IWong29/batterycharacterization/BatteryTesterV2.1.pdf

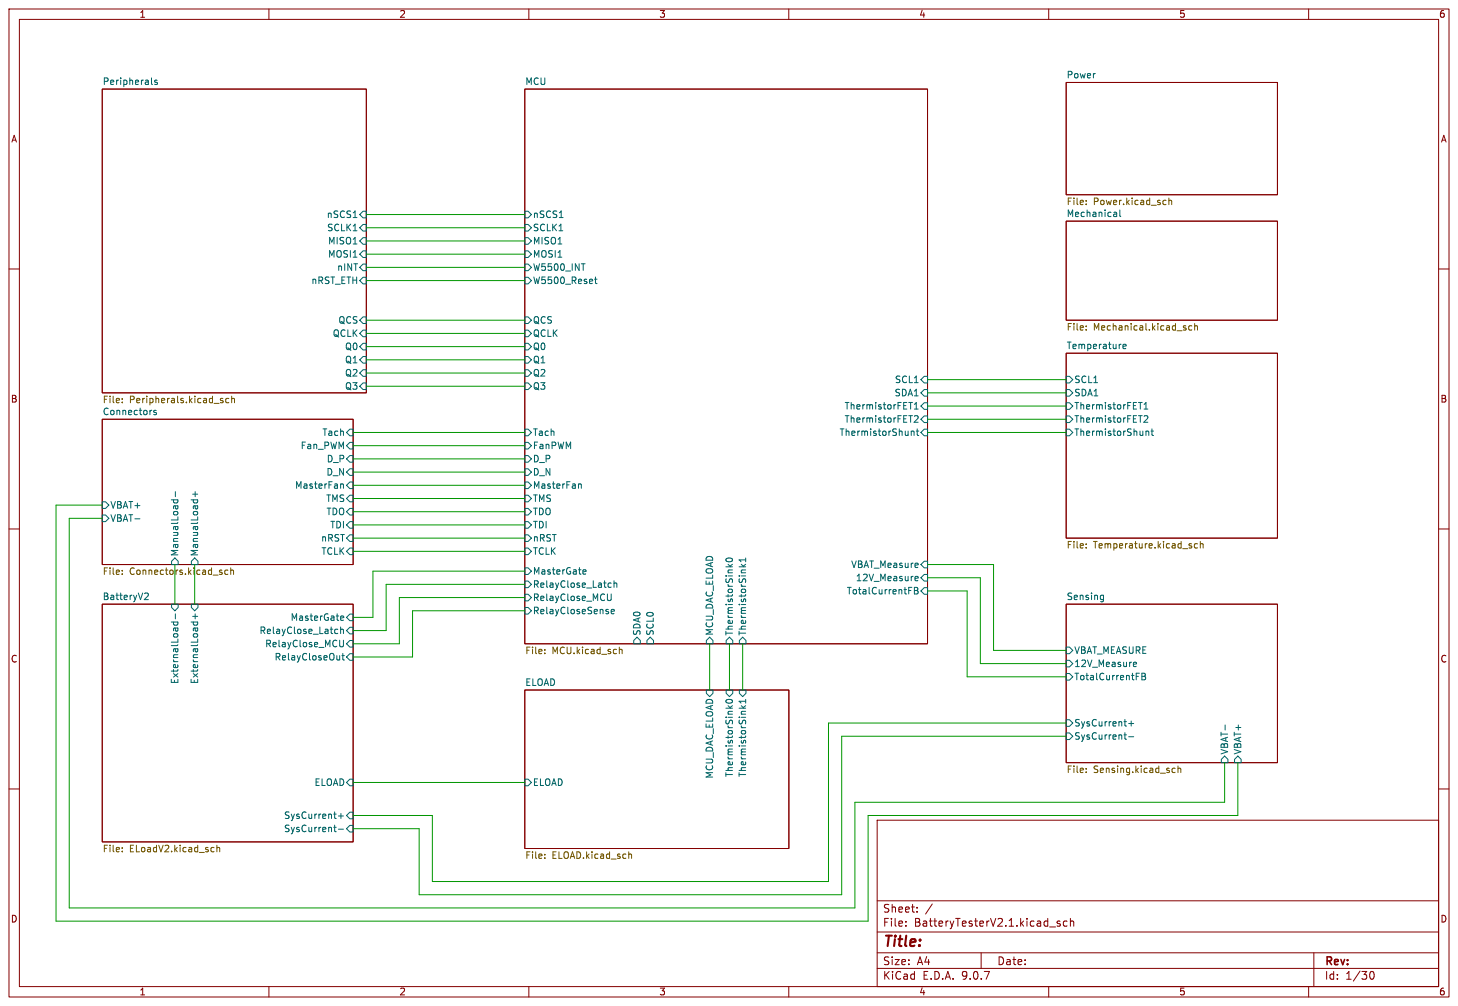
[picture p1: page 1]

Tach MasterFan VBAT+ VBAT- Connectors File: Connectors.kicad_sch

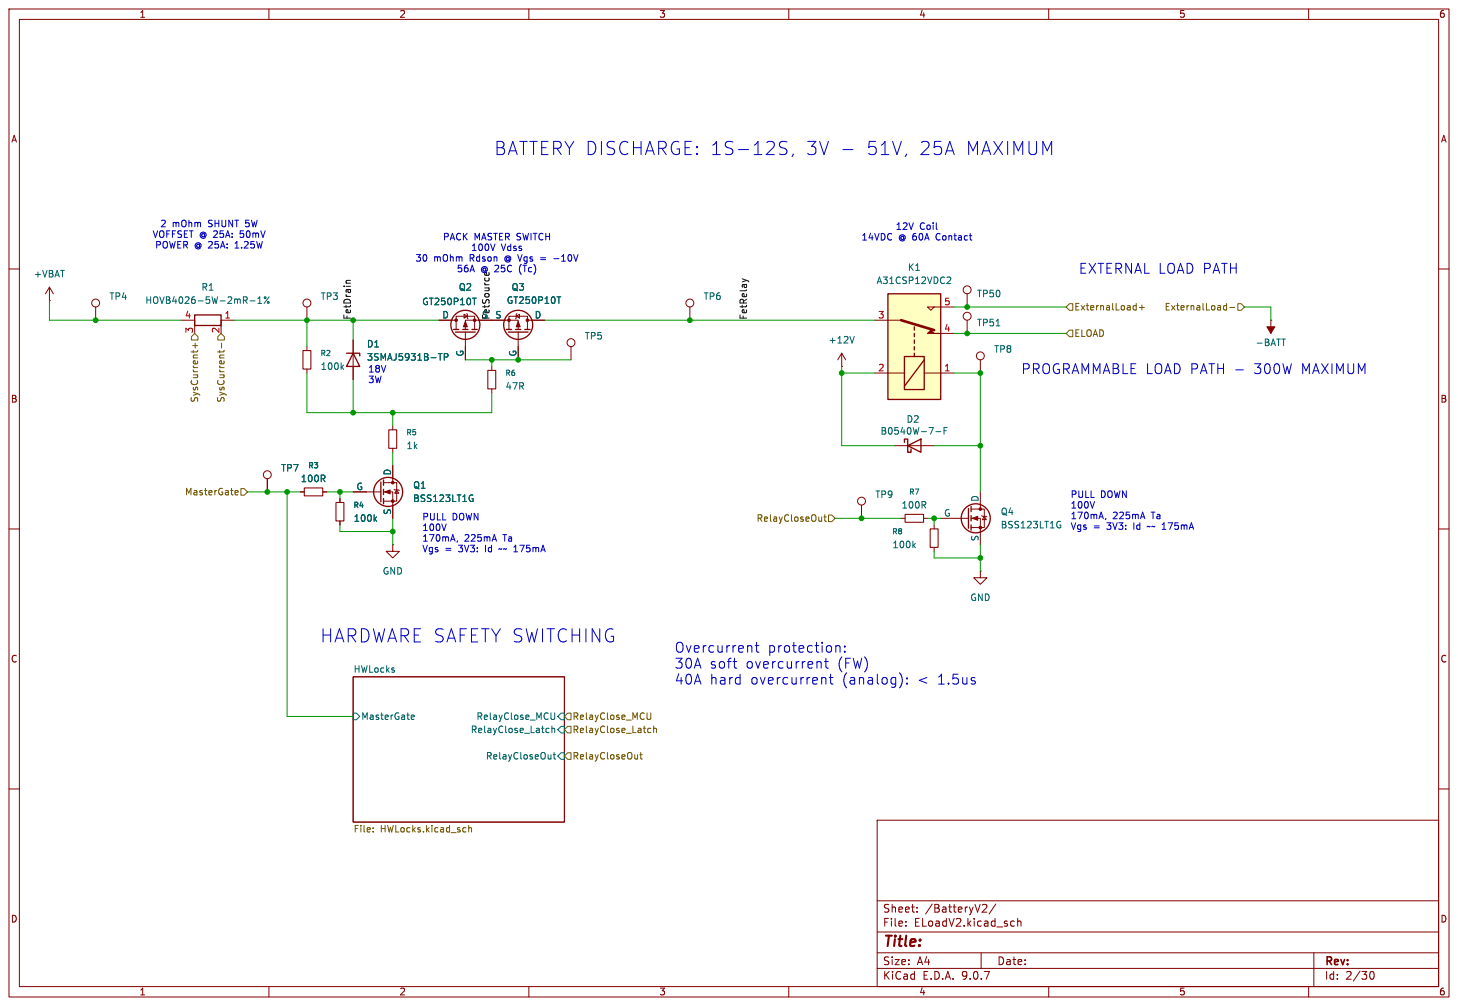
[picture p2: page 2]

100V Vdss 30 mOhm Rdson @ Vgs = -10V

170mA, 225mA Ta Vgs = 3V3: Id ~~ 175mA EXTERNAL LOAD PATH

ExternalLoad+ ELOAD MasterGate SysCurrent+

Id: 2/30 Title: File: ELoadV2.kicad_sch Sheet: /BatteryV2/

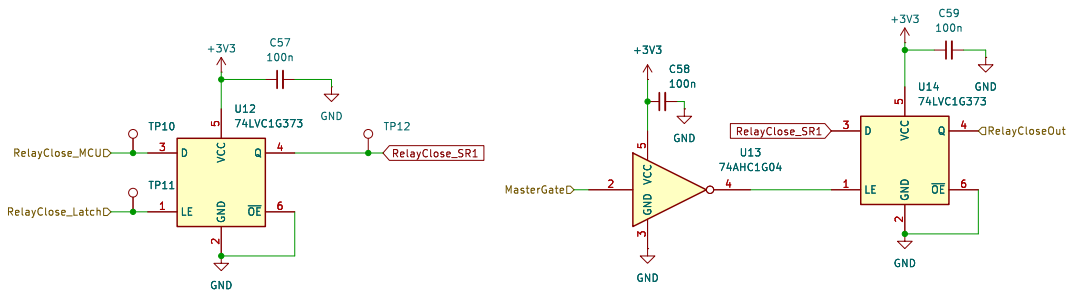
[picture p3: page 3]

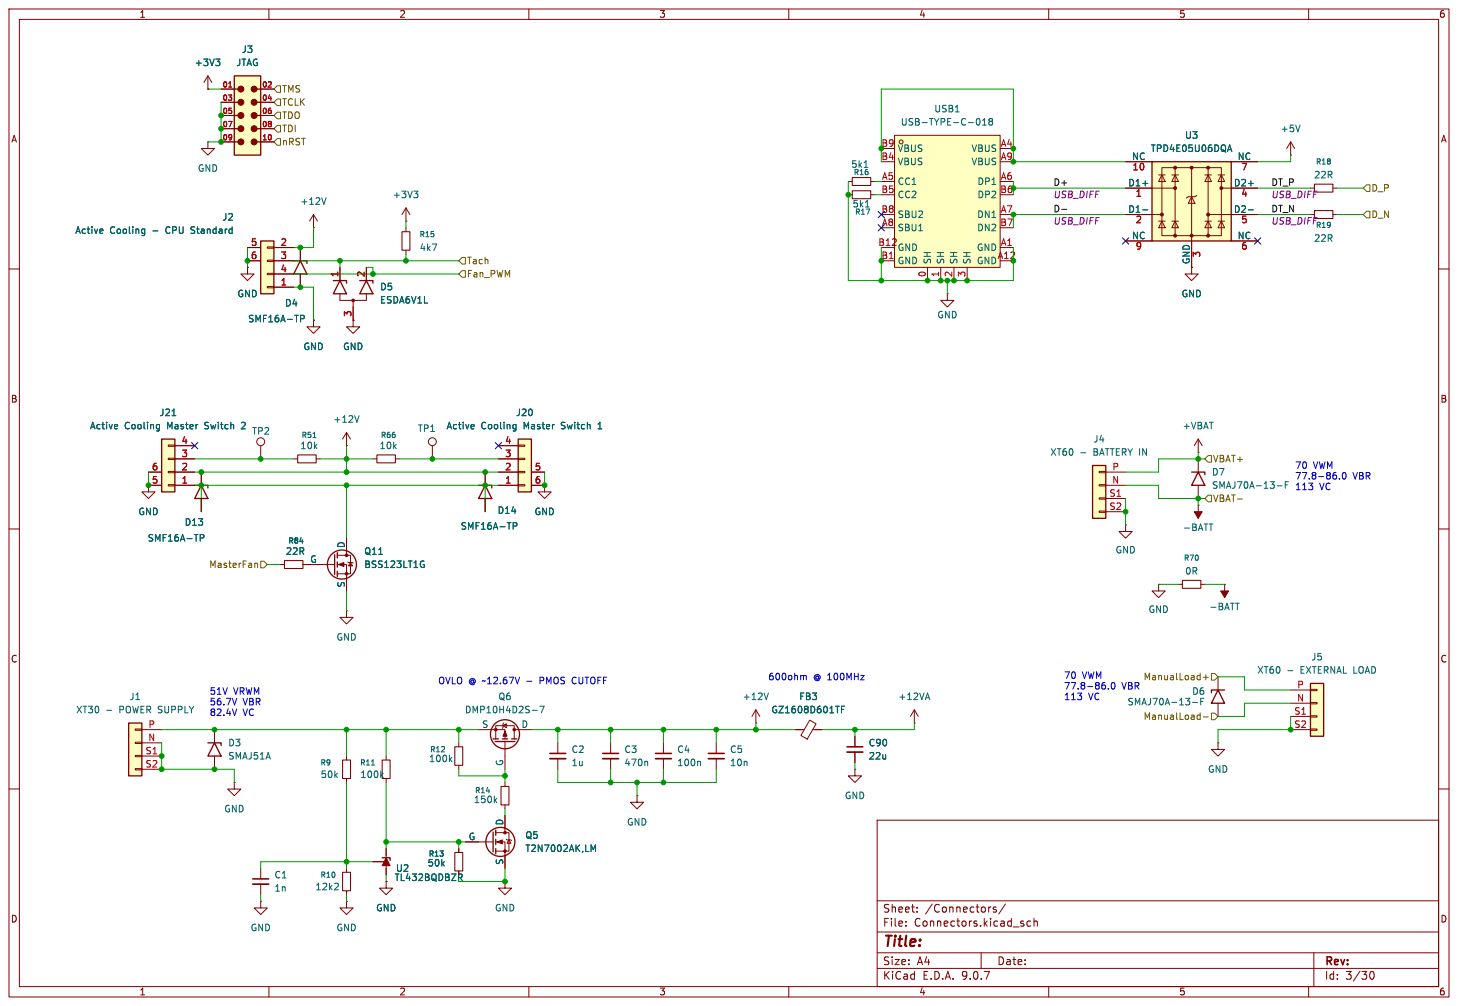
[picture p4: page 4]

3 VBUS A4 VBUS A9 DP1 A6 DP2 B6 DN1 A7 DN2 B7 GND A1 GNDA12 USB1 USB-TYPE-C-018 GND

J21 Active Cooling Master Switch 2

J20 Active Cooling Master Switch 1

Id: 3/30 Title: File: Connectors.kicad_sch Sheet: /Connectors/ FB3 GZ1608D601TF GND

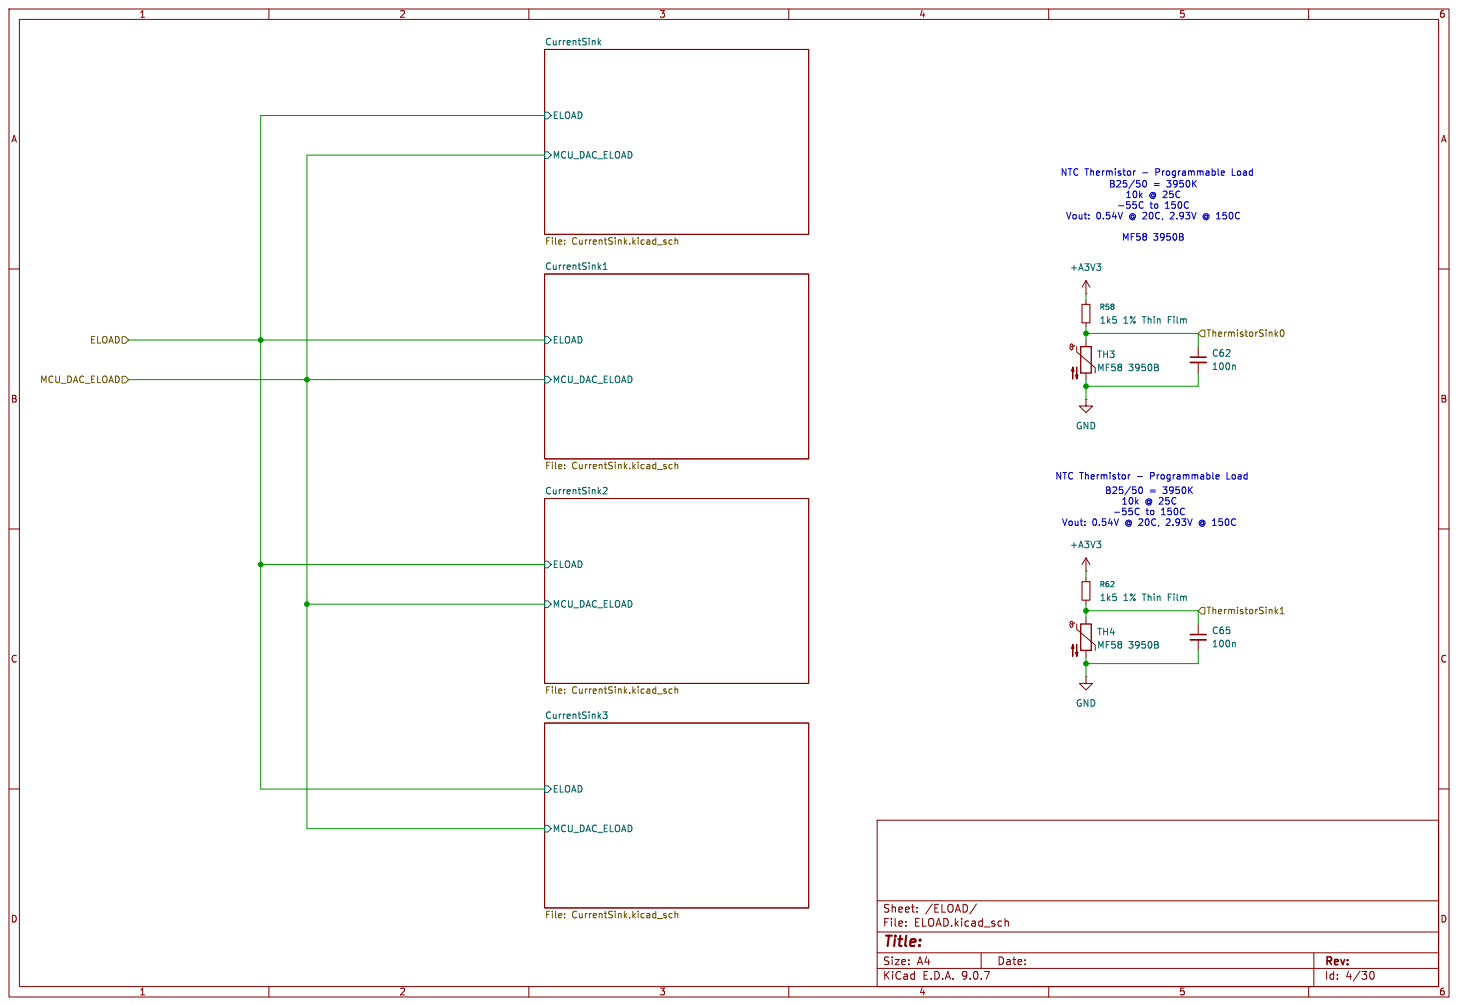
[picture p5: page 5]

Id: 4/30 Title: File: ELOAD.kicad_sch Sheet: /ELOAD/

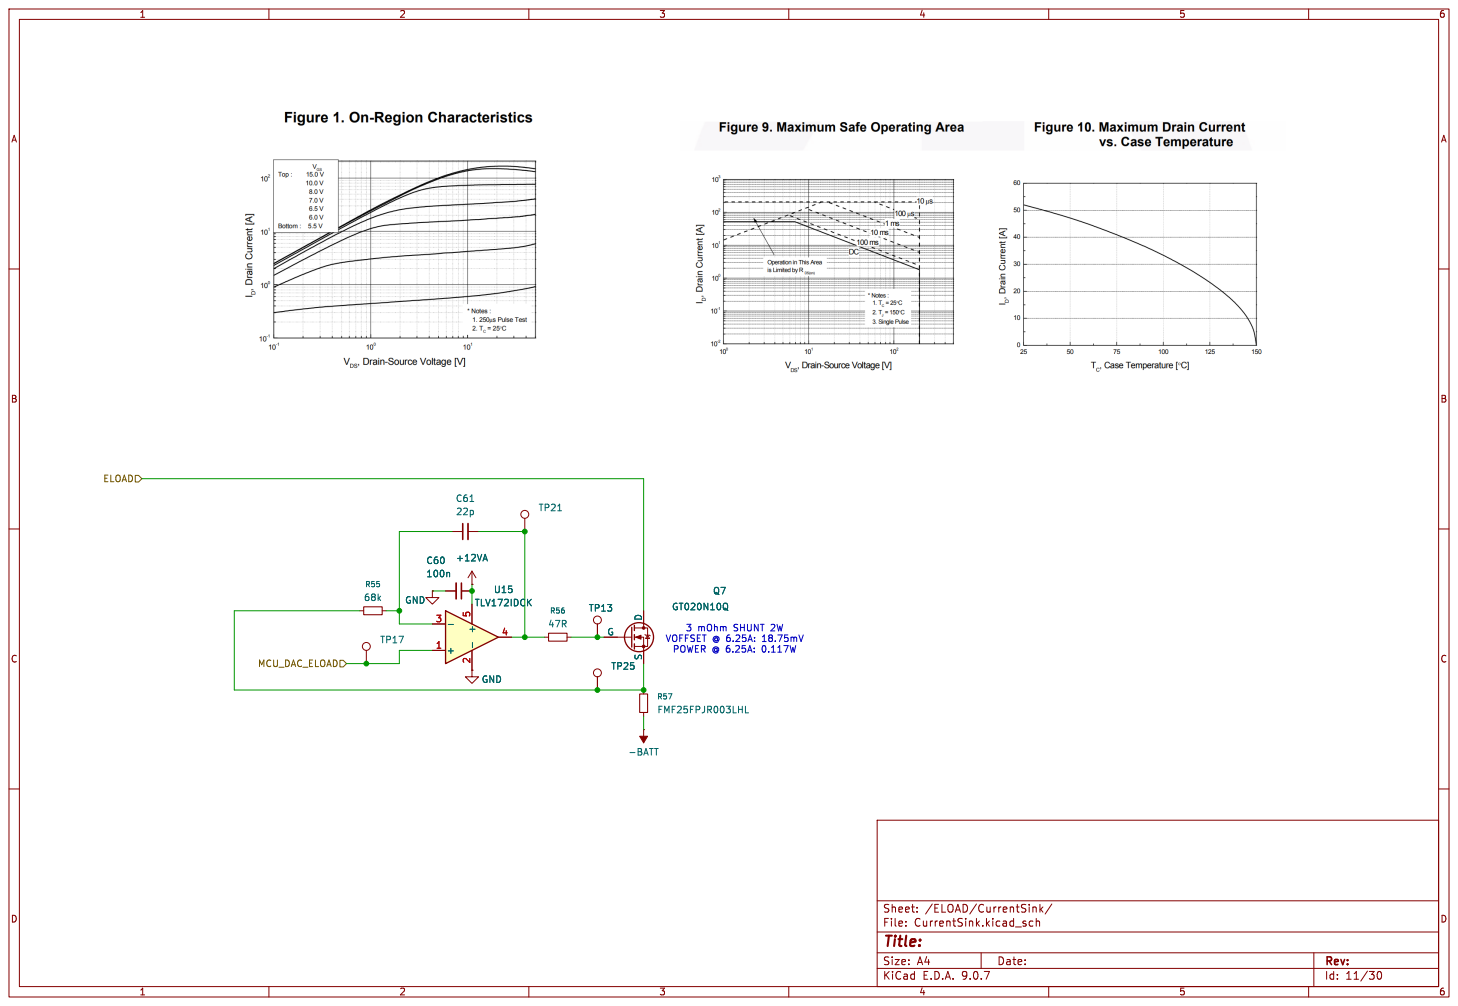
[picture p6: page 6]

Id: 11/30 Title: File: CurrentSink.kicad_sch Sheet: /ELOAD/CurrentSink/ TP13 GND

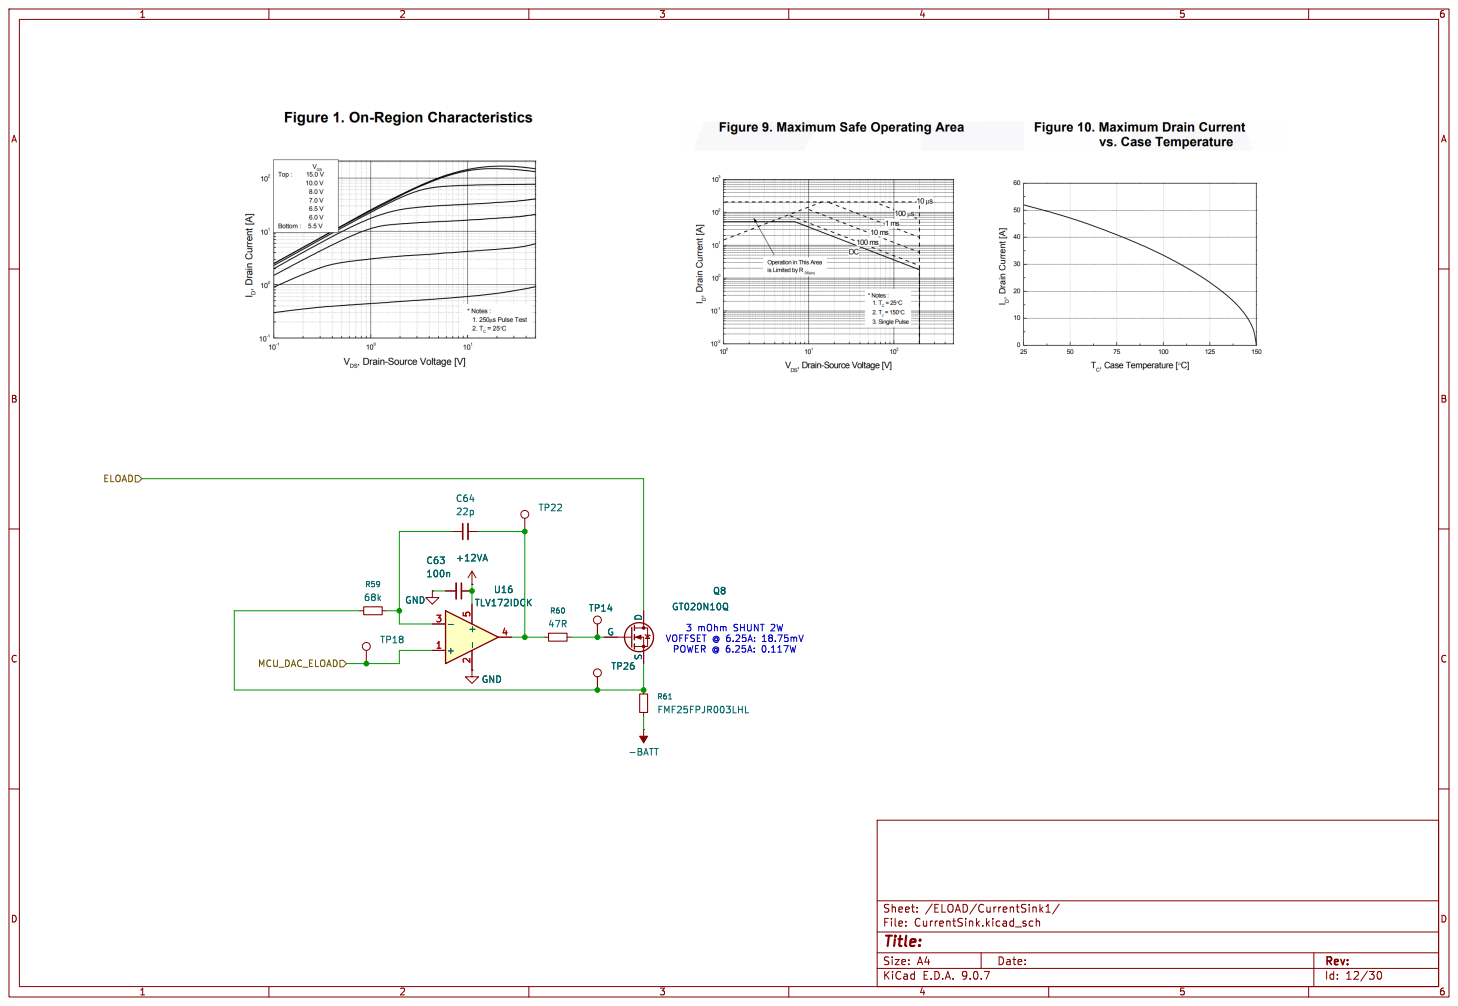
[picture p7: page 7]

Id: 12/30 Title: File: CurrentSink.kicad_sch Sheet: /ELOAD/CurrentSink1/ GND

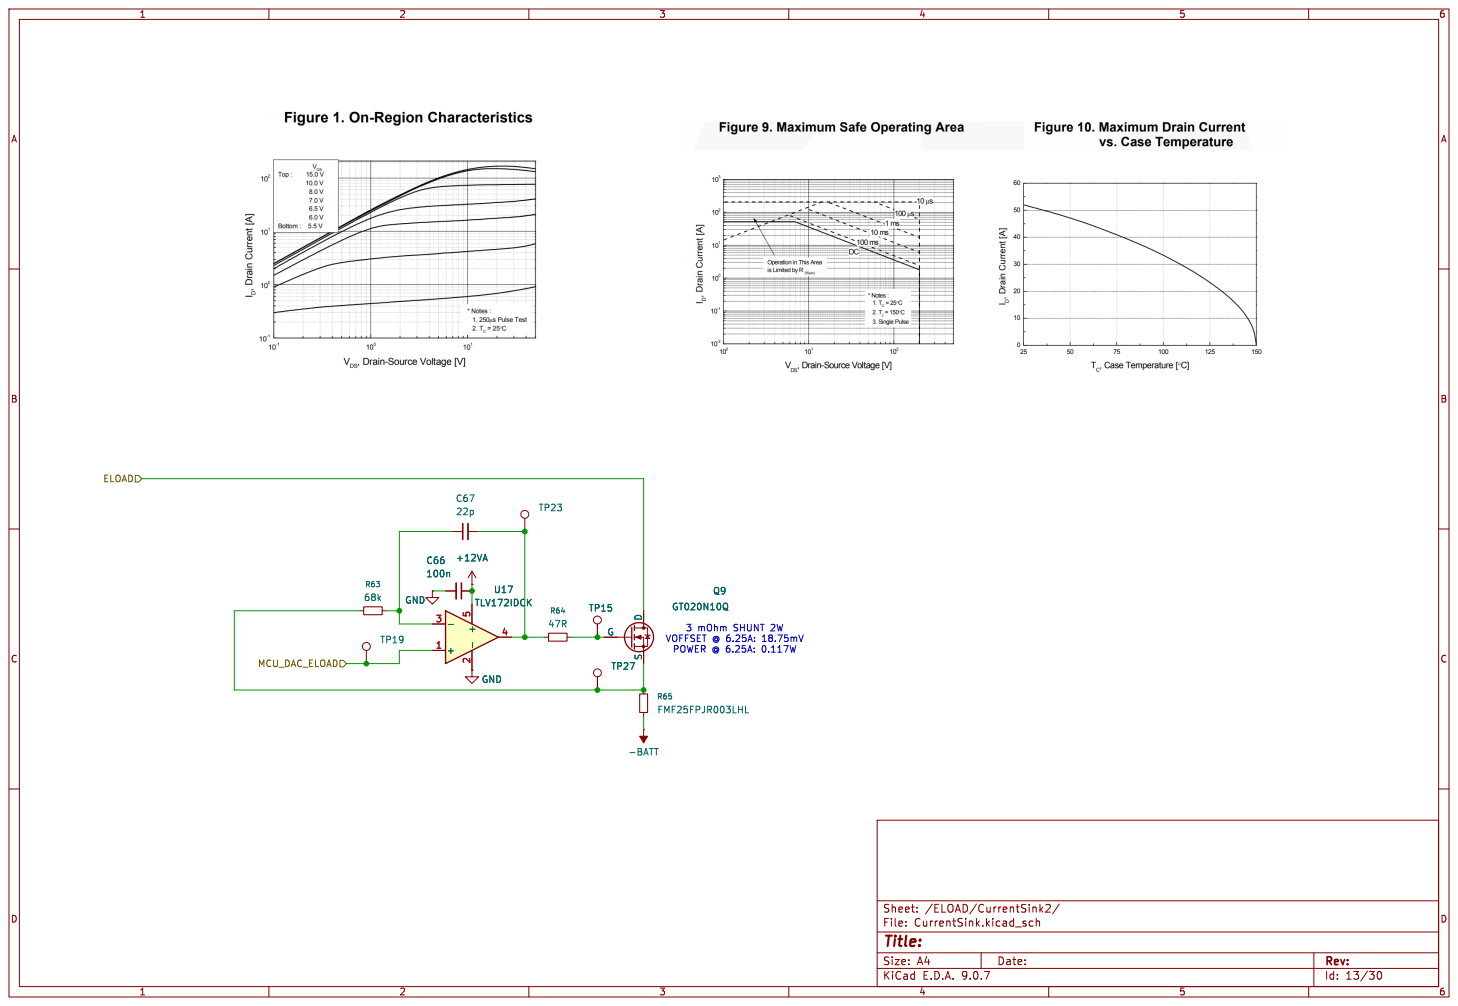
[picture p8: page 8]

Id: 13/30 Title: File: CurrentSink.kicad_sch Sheet: /ELOAD/CurrentSink2/

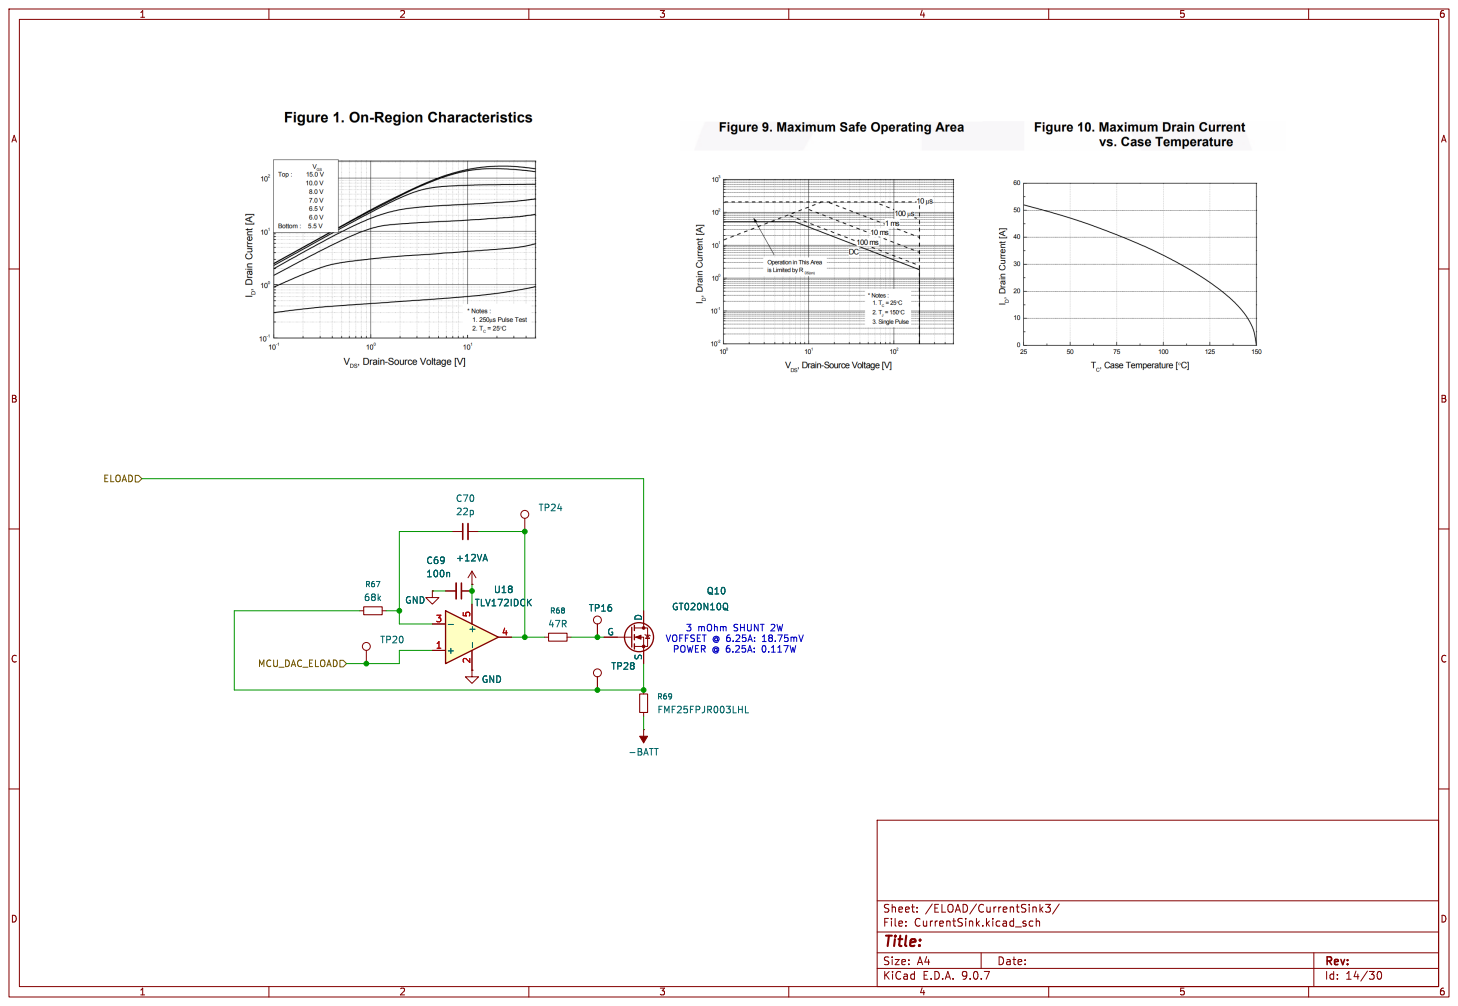
[picture p9: page 9]

Id: 14/30 Title: File: CurrentSink.kicad_sch Sheet: /ELOAD/CurrentSink3/ TP16 GND

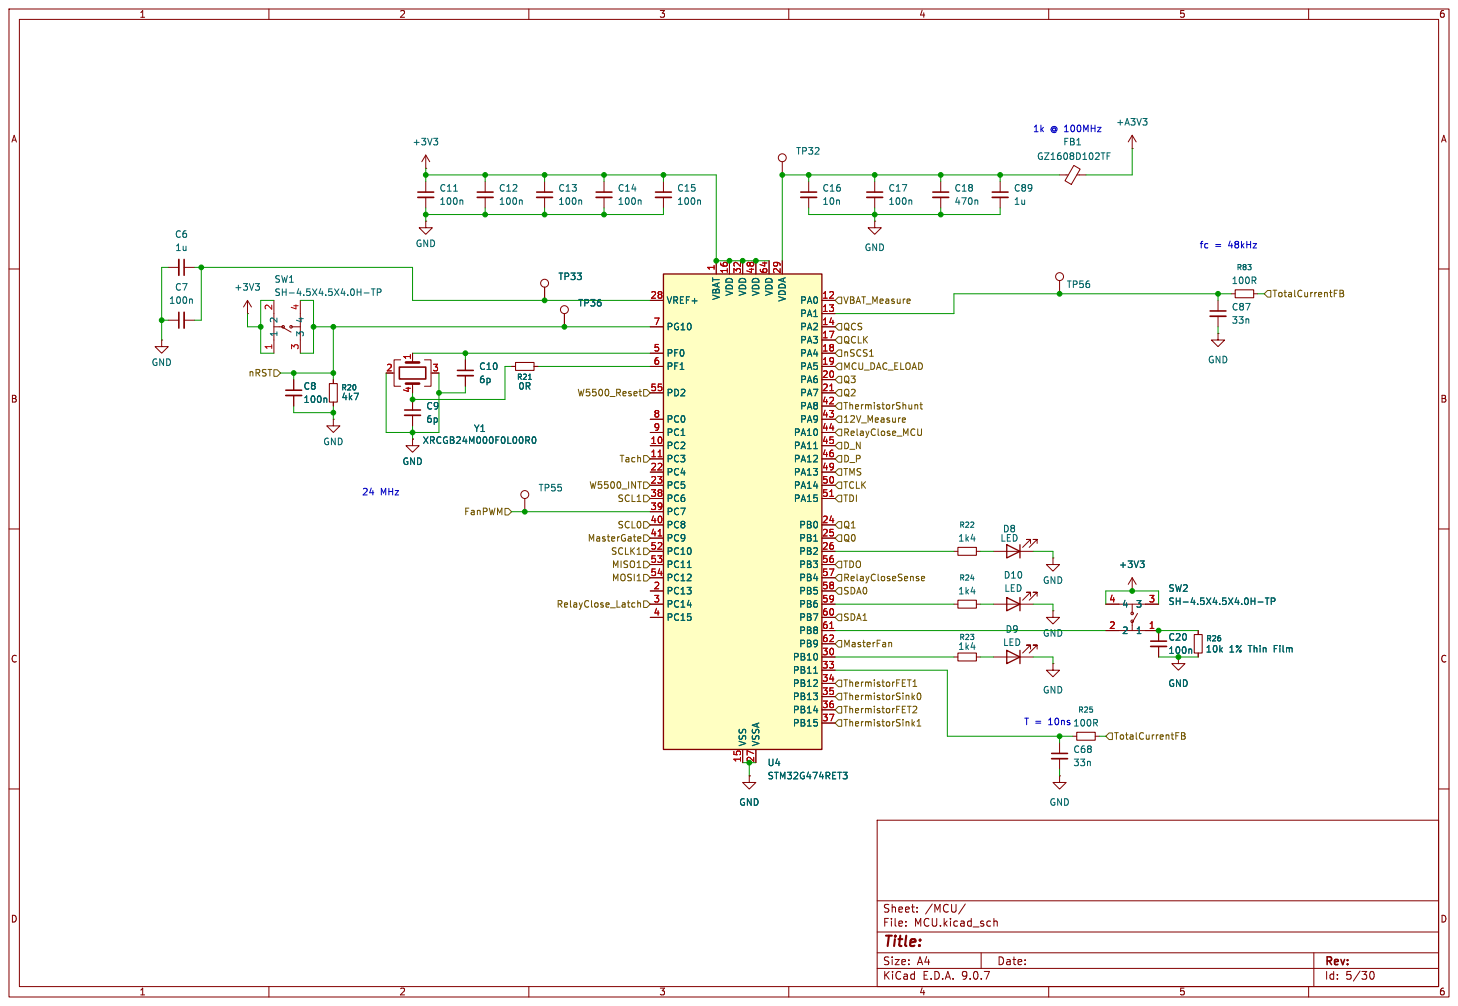
[picture p10: page 10]

1 VDD 16 VDD 32 VSS 15 VDD 48 VSSA 27 VDD 64 VDDA 29 PA0 12 PA1 13 PA2 14 PA3 17 PA4 18 PA5 19 PA6 20 PA7 21 PA8 42 PA9 43 PA10 44 PA11 45 PA12 46 PA13 49 PA14 50 PA15 51 PB0 24 PB1 25 PB2 26 PB3 56 PB4 57 PB5 58 PB6 59 PB7 60 PB8 61 PB9 62 PB10 30 PB11 33 PB12 34 PB13 35 PB14 36 PB15 37 U4STM32G474RET3 GND

1 VDD 16 VDD 32 VSS 15 VDD 48 VSSA 27 VDD 64 VDDA 29 PA0 12 PA1 13 PA2 14 PA3 17 PA4 18 PA5 19 PA6 20 PA7 21 PA8 42 PA9 43 PA10 44 PA11 45 PA12 46 PA13 49 PA14 50 PA15 51 PB0 24 PB1 25 PB2 26 PB3 56 PB4 57 PB5 58 PB6 59 PB7 60 PB8 61 PB9 62 PB10 30 PB11 33 PB12 34 PB13 35 PB14 36 PB15 37 GND

Id: 5/30 Title: File: MCU.kicad_sch Sheet: /MCU/ GND

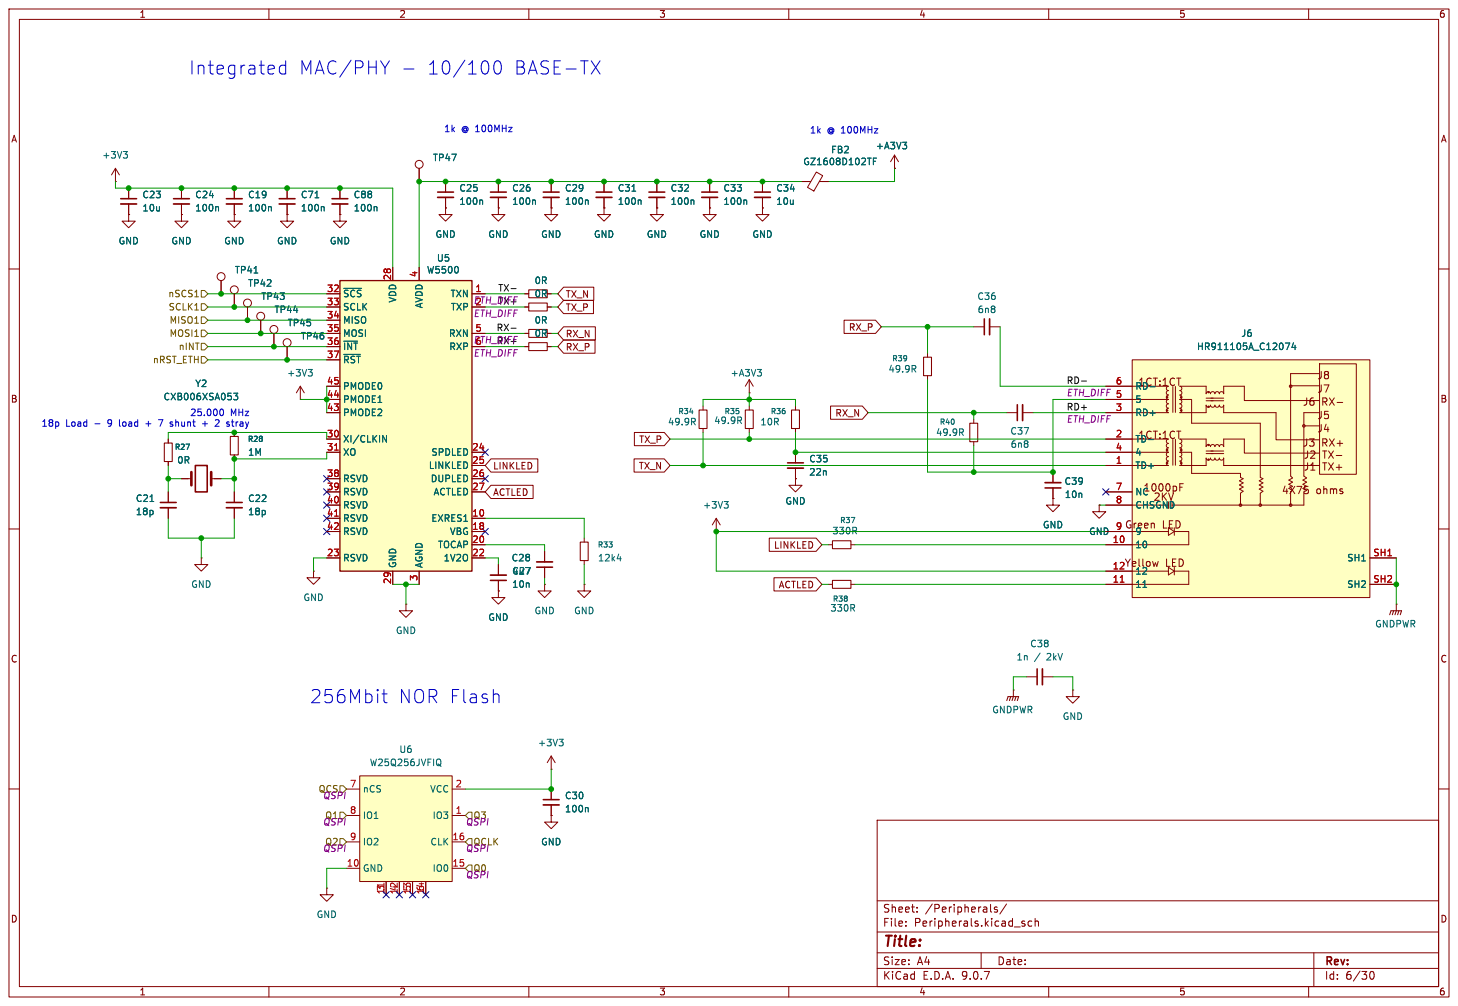
[picture p11: page 11]

3 TXN 1 TXP 2 RXN 5 RXP 6 SPDLED 24

LINKLED 25 DUPLED 26 ACTLED 27 EXRES1 10 VBG 18 TOCAP 20

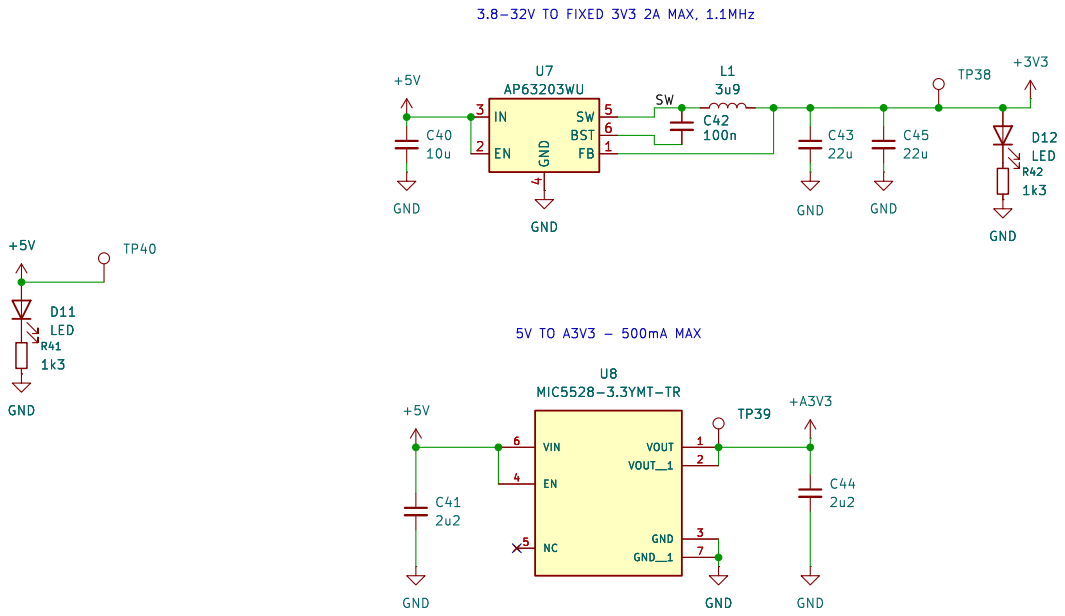
[picture p12: page 12]

4 SW 5 BST 6 FB 1 U7 AP63203WU GND GND GND

4 SW 5 BST 6 FB 1 GND

Id: 7/30 Title: File: Power.kicad_sch Sheet: /Power/

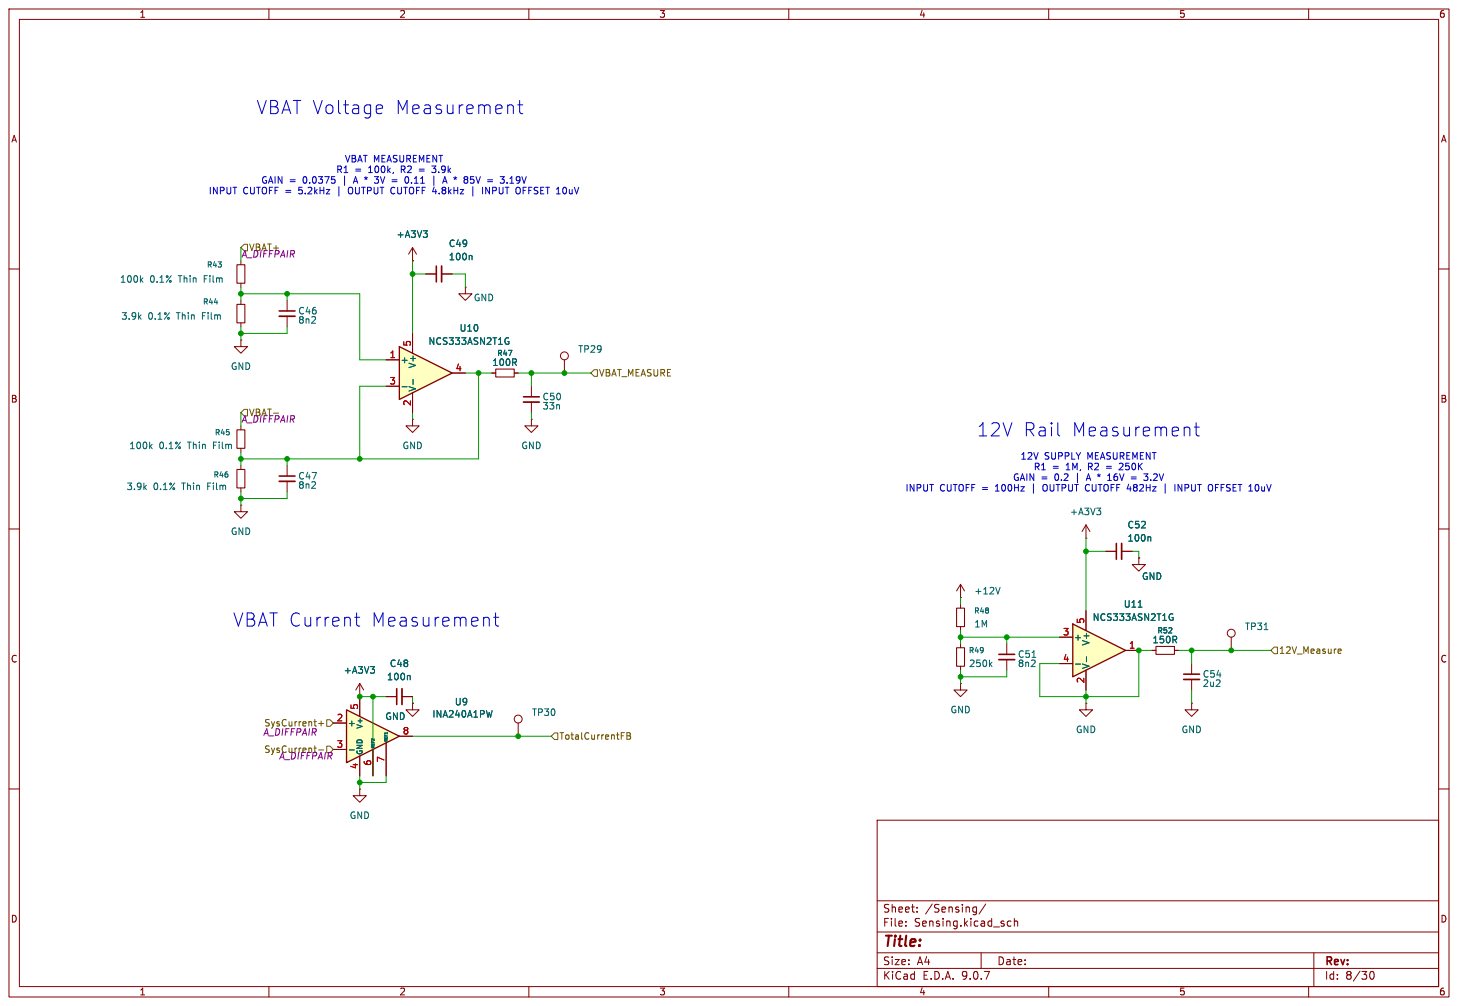
[picture p13: page 13]

INPUT CUTOFF = 100Hz | OUTPUT CUTOFF 482Hz | INPUT OFFSET 10uV

Id: 8/30 Title: File: Sensing.kicad_sch Sheet: /Sensing/ GND

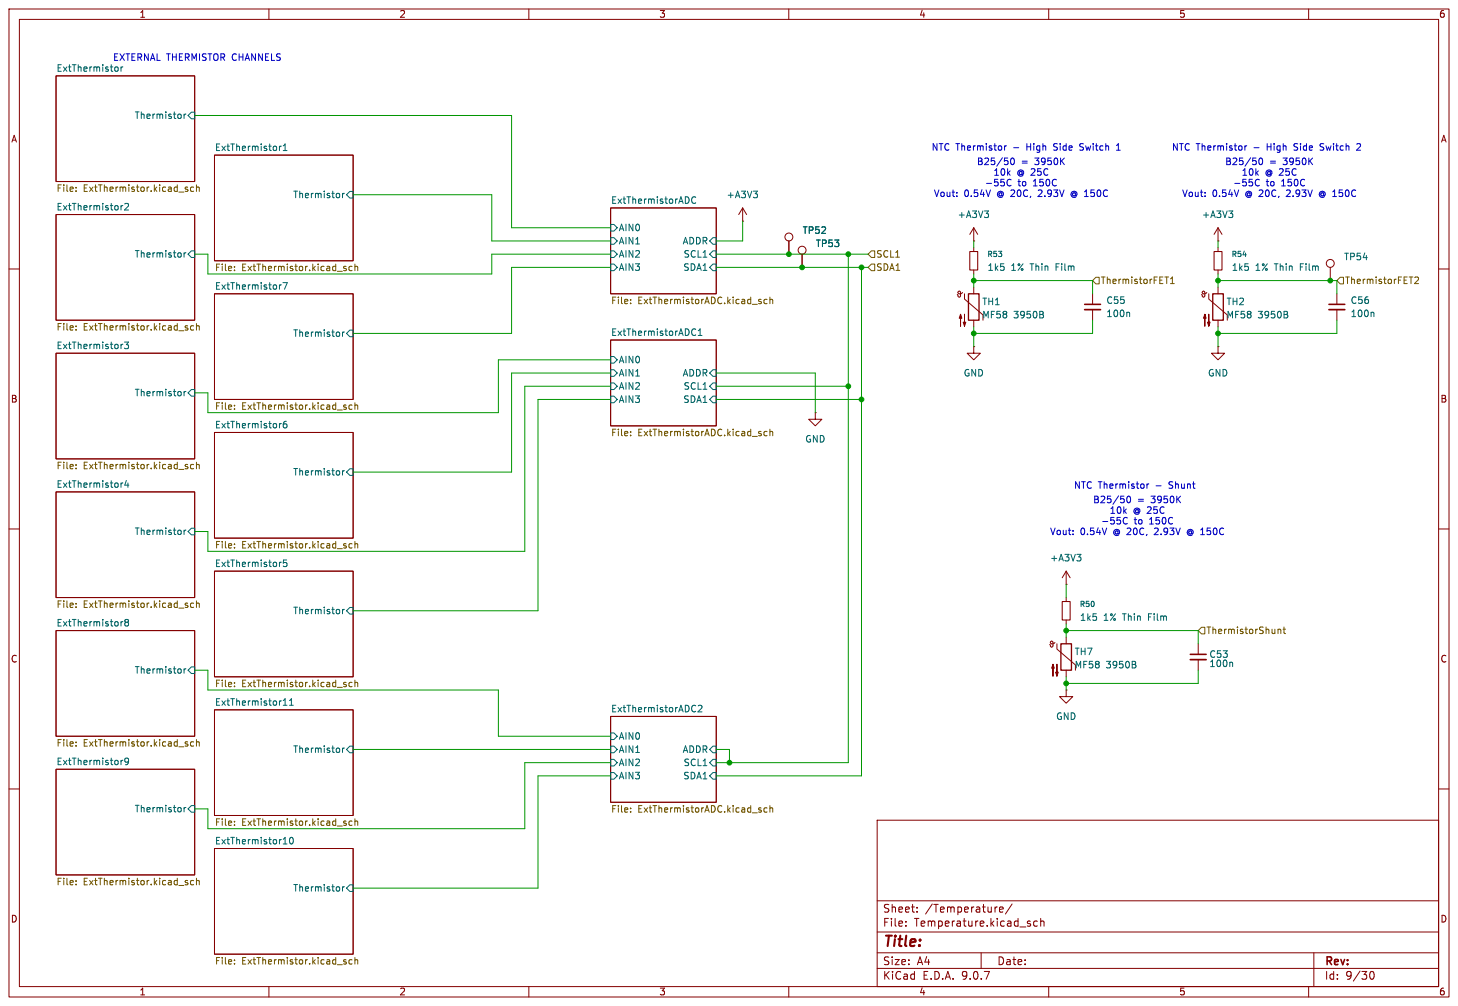
[picture p14: page 14]

Thermistor ExtThermistor7 File: ExtThermistor.kicad_sch Thermistor ExtThermistor File: ExtThermistor.kicad_sch Thermistor ExtThermistor4 File: ExtThermistor.kicad_sch Thermistor ExtThermistor9 File: ExtThermistor.kicad_sch

Id: 9/30 Title: File: Temperature.kicad_sch Sheet: /Temperature/

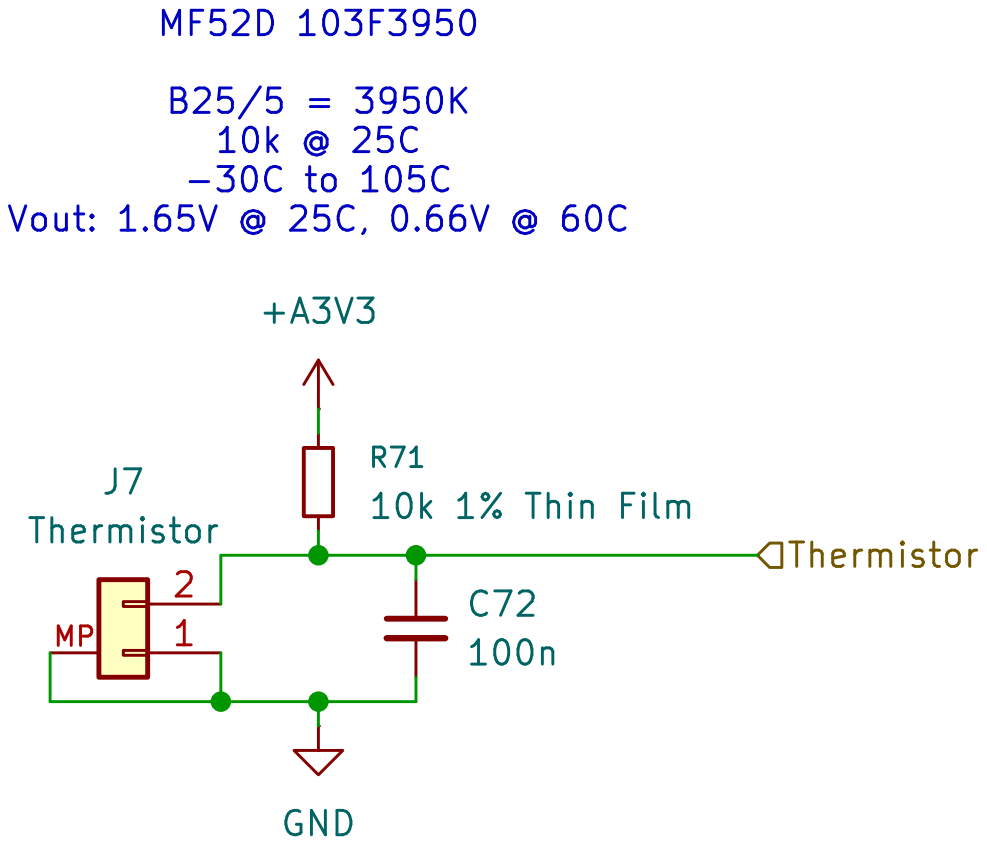
[picture p15: page 15]

Id: 15/30 Title: File: ExtThermistor.kicad_sch Sheet: /Temperature/ExtThermistor/

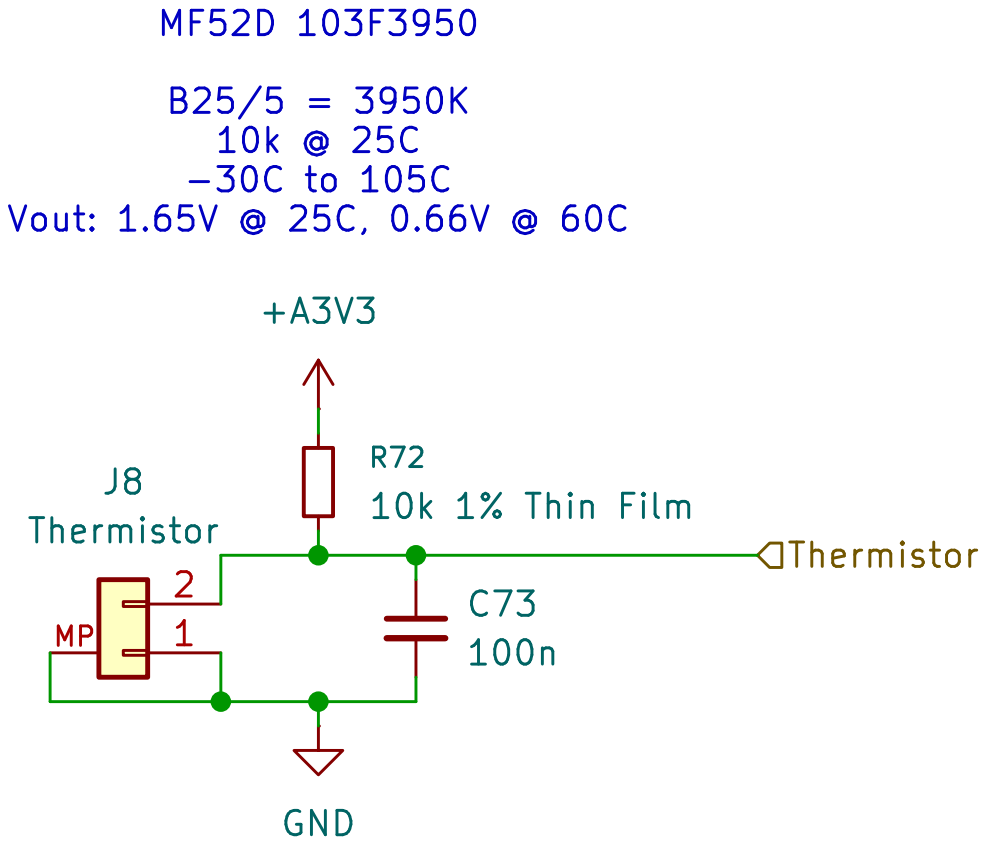
[picture p16: page 16]

Id: 16/30 Title: File: ExtThermistor.kicad_sch Sheet: /Temperature/ExtThermistor1/

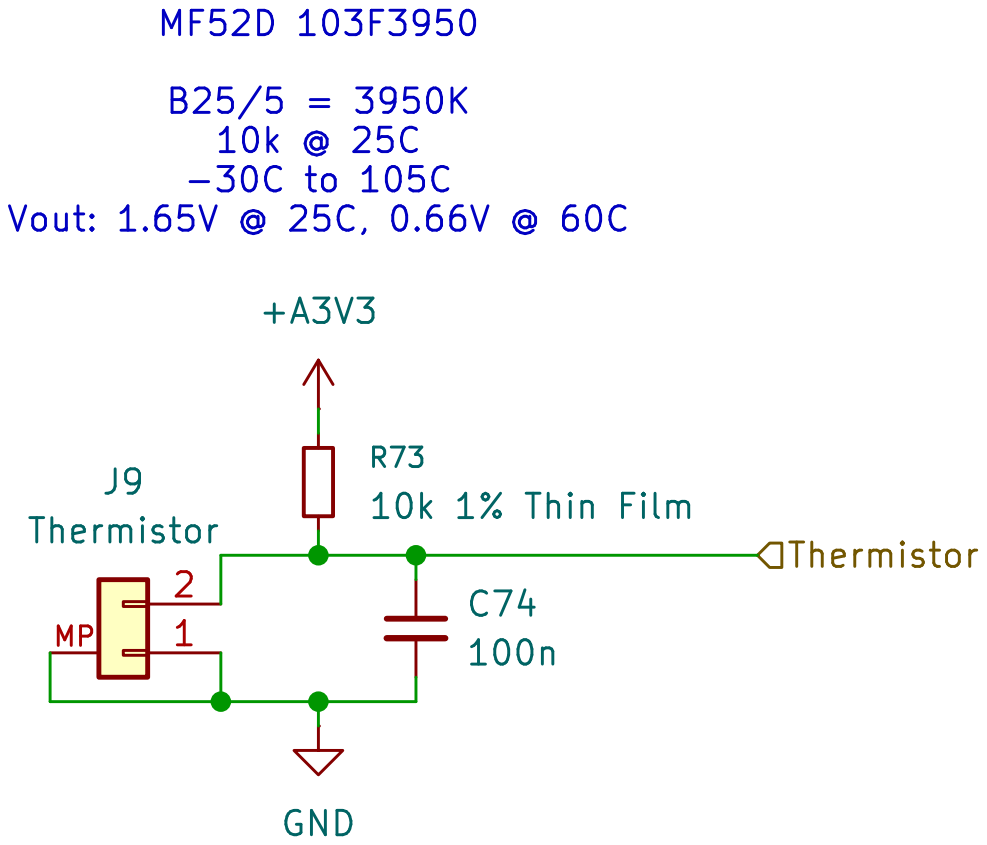
[picture p17: page 17]

Id: 17/30 Title: File: ExtThermistor.kicad_sch Sheet: /Temperature/ExtThermistor2/

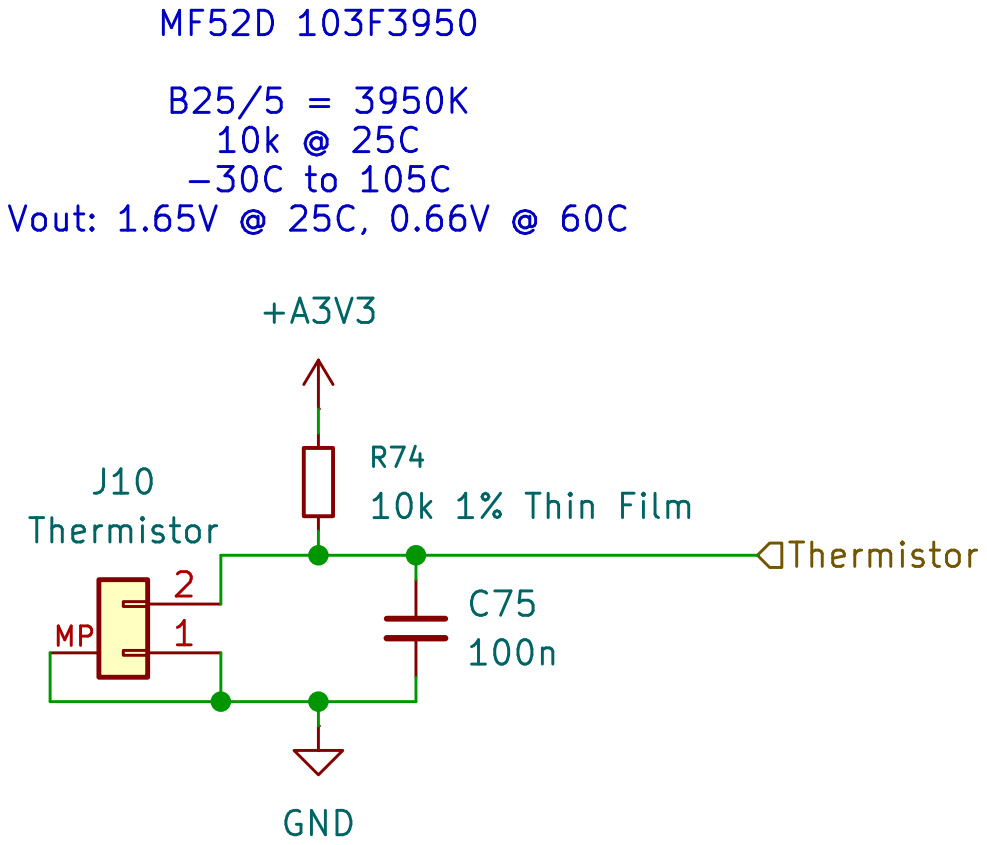
[picture p18: page 18]

Id: 18/30 Title: File: ExtThermistor.kicad_sch Sheet: /Temperature/ExtThermistor3/

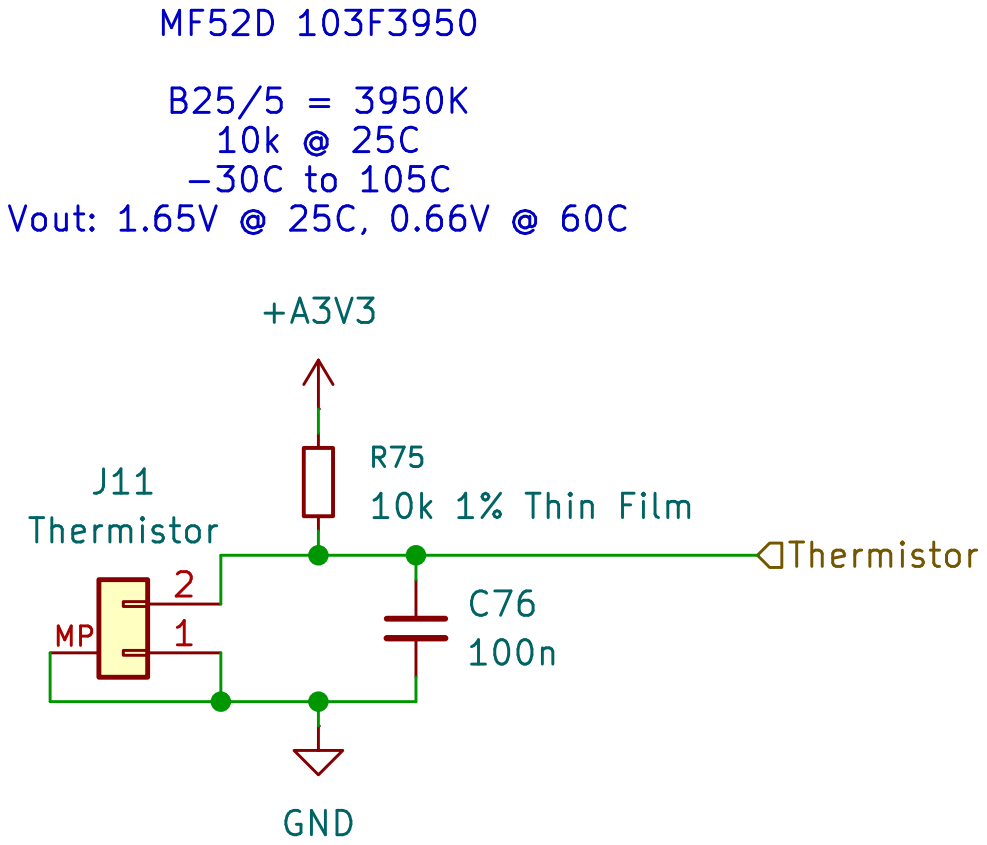
[picture p19: page 19]

Id: 19/30 Title: File: ExtThermistor.kicad_sch Sheet: /Temperature/ExtThermistor4/

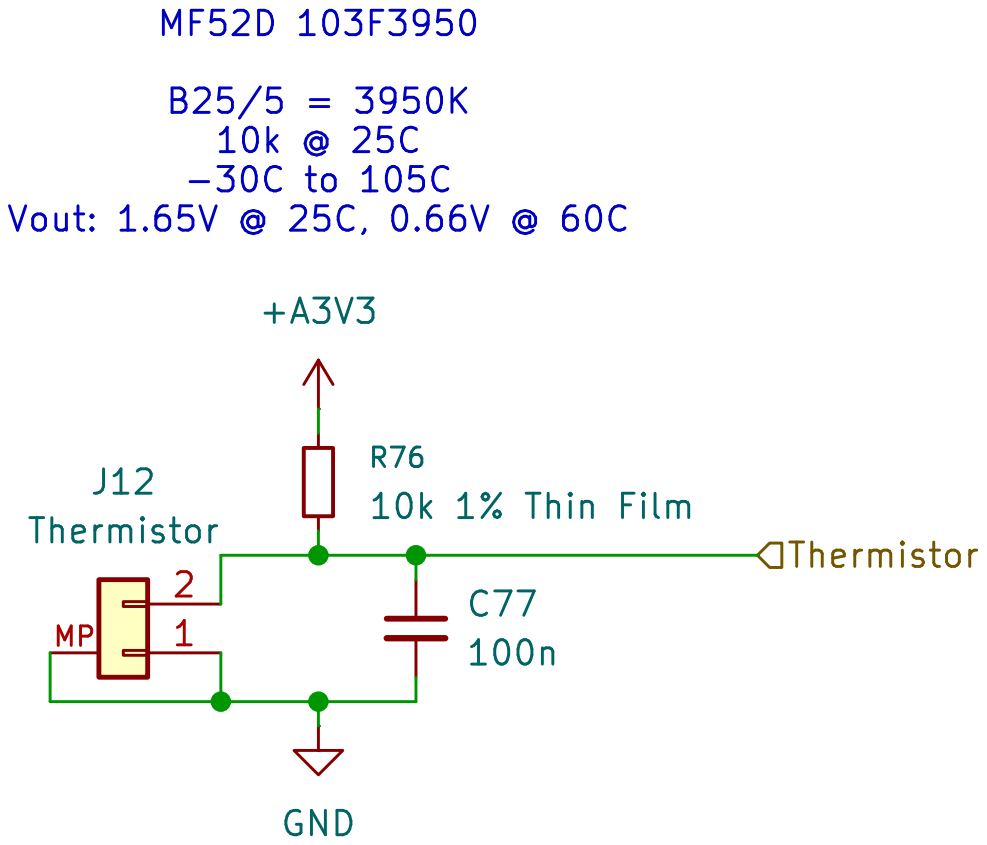
[picture p20: page 20]

Id: 20/30 Title: File: ExtThermistor.kicad_sch Sheet: /Temperature/ExtThermistor5/

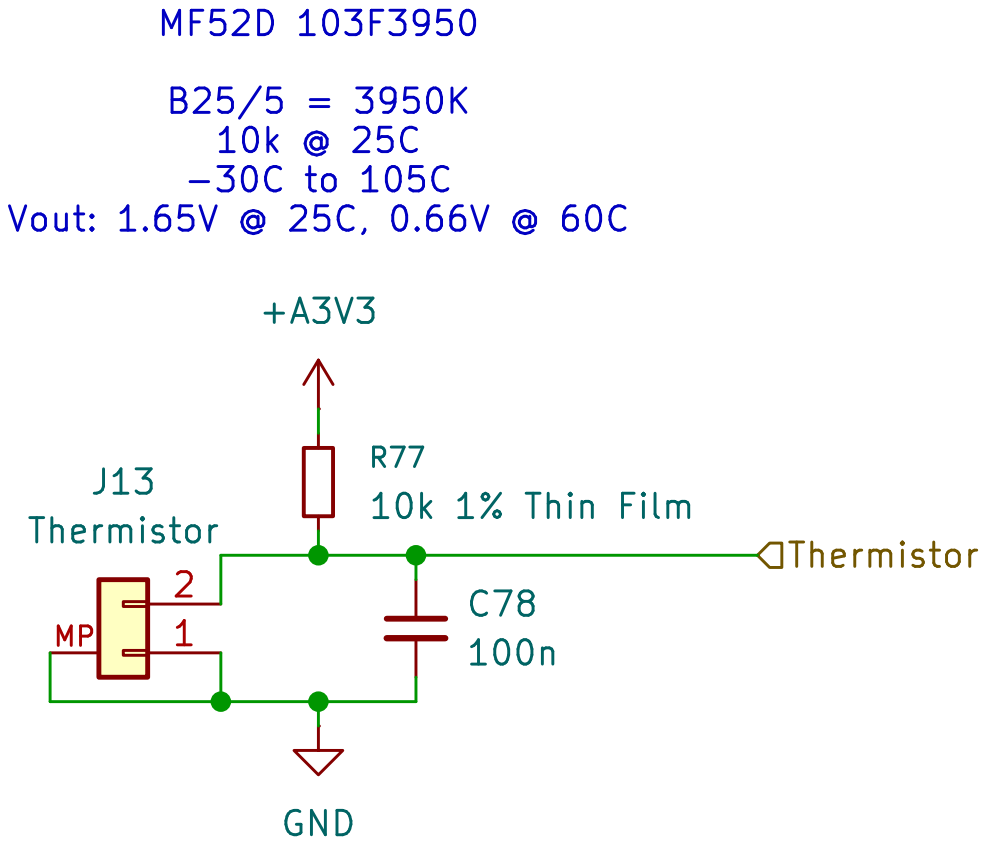
[picture p21: page 21]

Id: 21/30 Title: File: ExtThermistor.kicad_sch Sheet: /Temperature/ExtThermistor6/

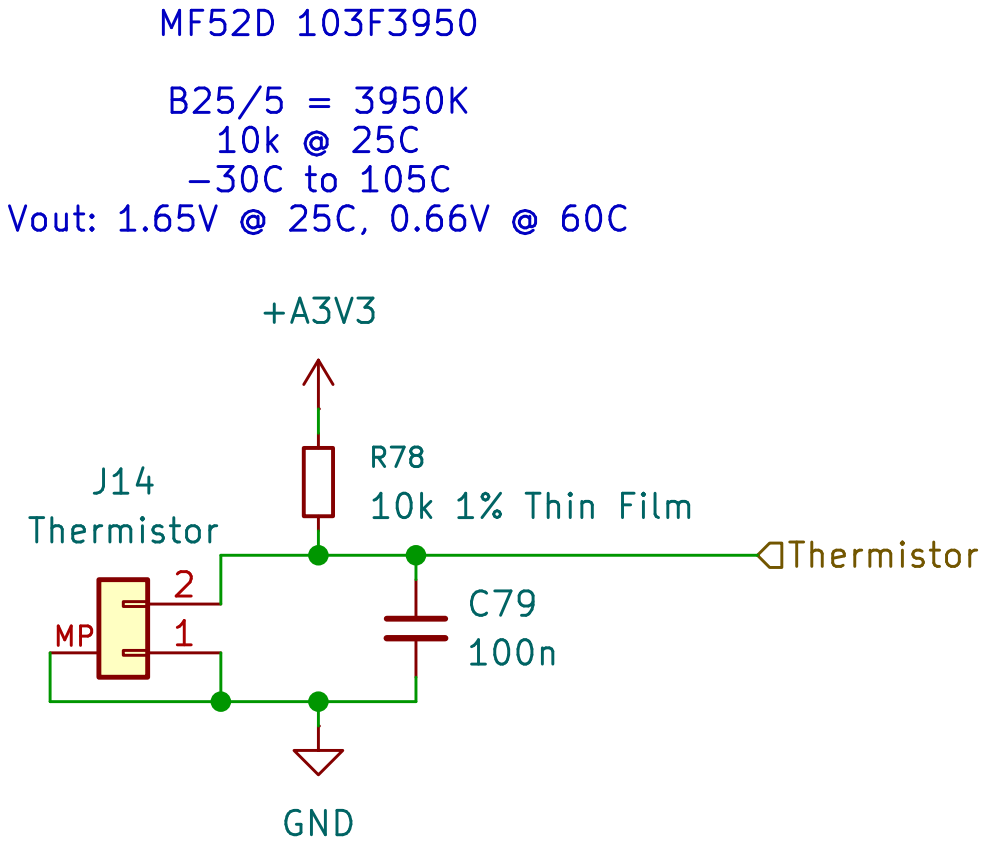
[picture p22: page 22]

Id: 22/30 Title: File: ExtThermistor.kicad_sch Sheet: /Temperature/ExtThermistor7/

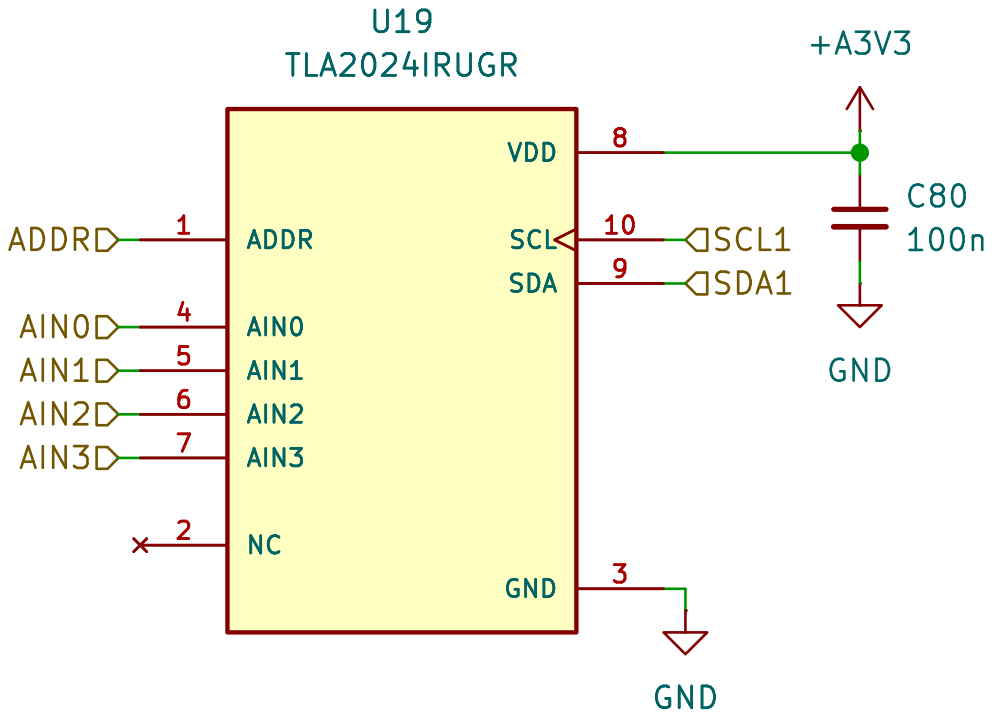
[picture p23: page 23]

Id: 23/30 Title: File: ExtThermistorADC.kicad_sch Sheet: /Temperature/ExtThermistorADC/

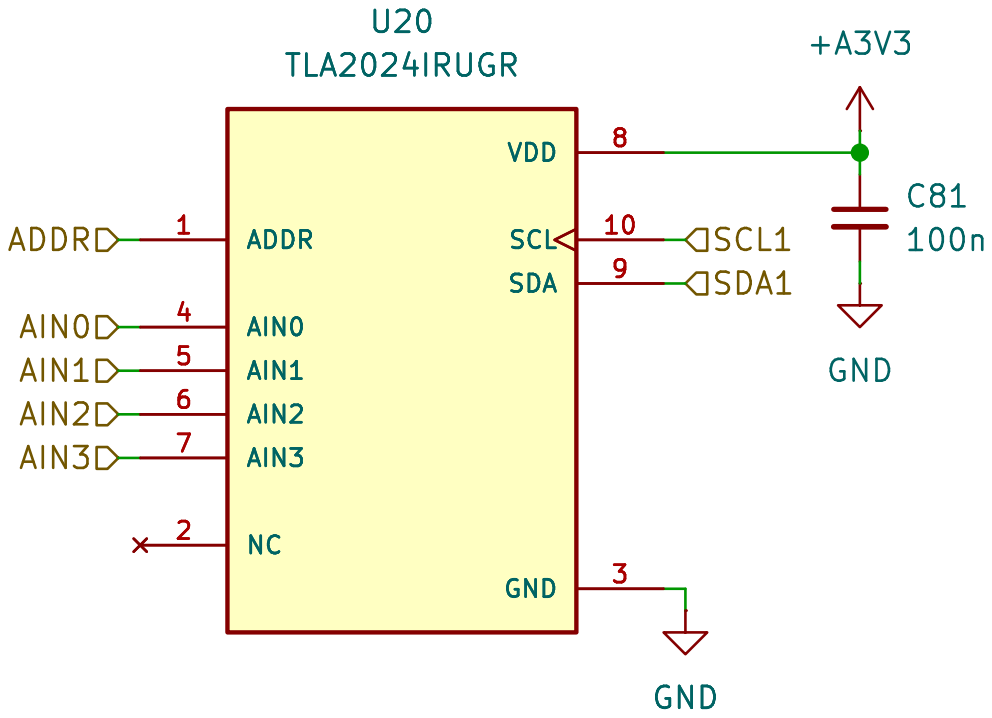
[picture p24: page 24]

Id: 24/30 Title: File: ExtThermistorADC.kicad_sch Sheet: /Temperature/ExtThermistorADC1/

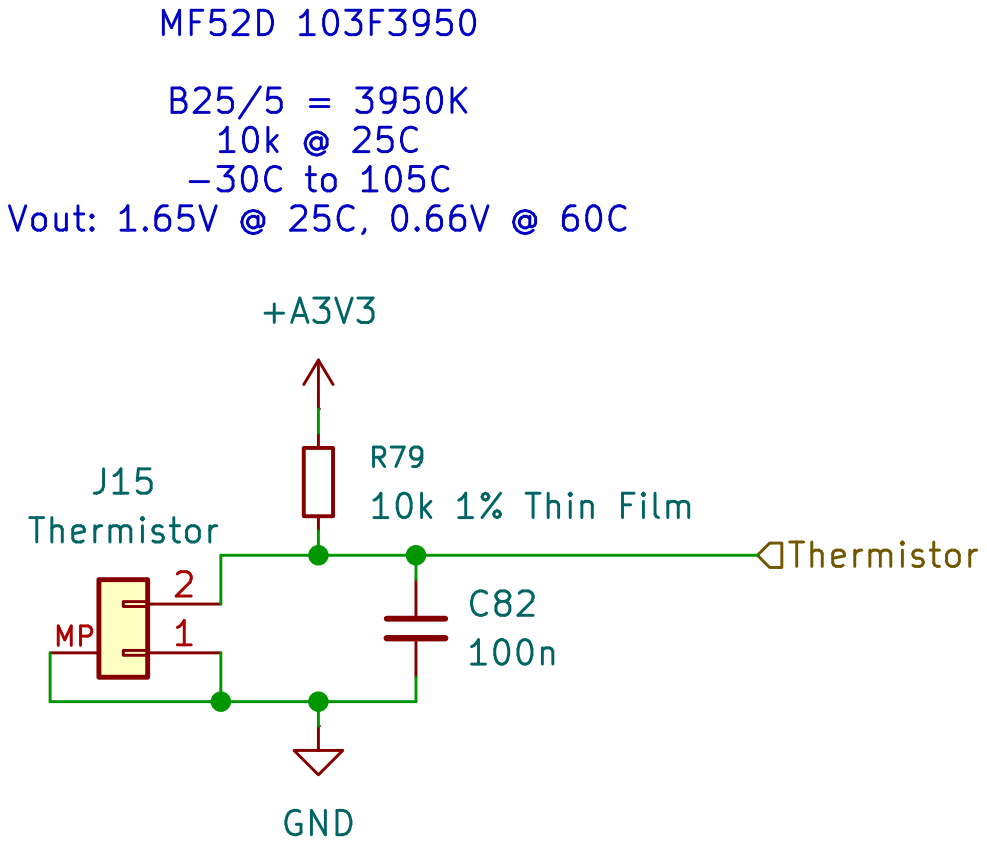
[picture p25: page 25]

Id: 25/30 Title: File: ExtThermistor.kicad_sch Sheet: /Temperature/ExtThermistor8/

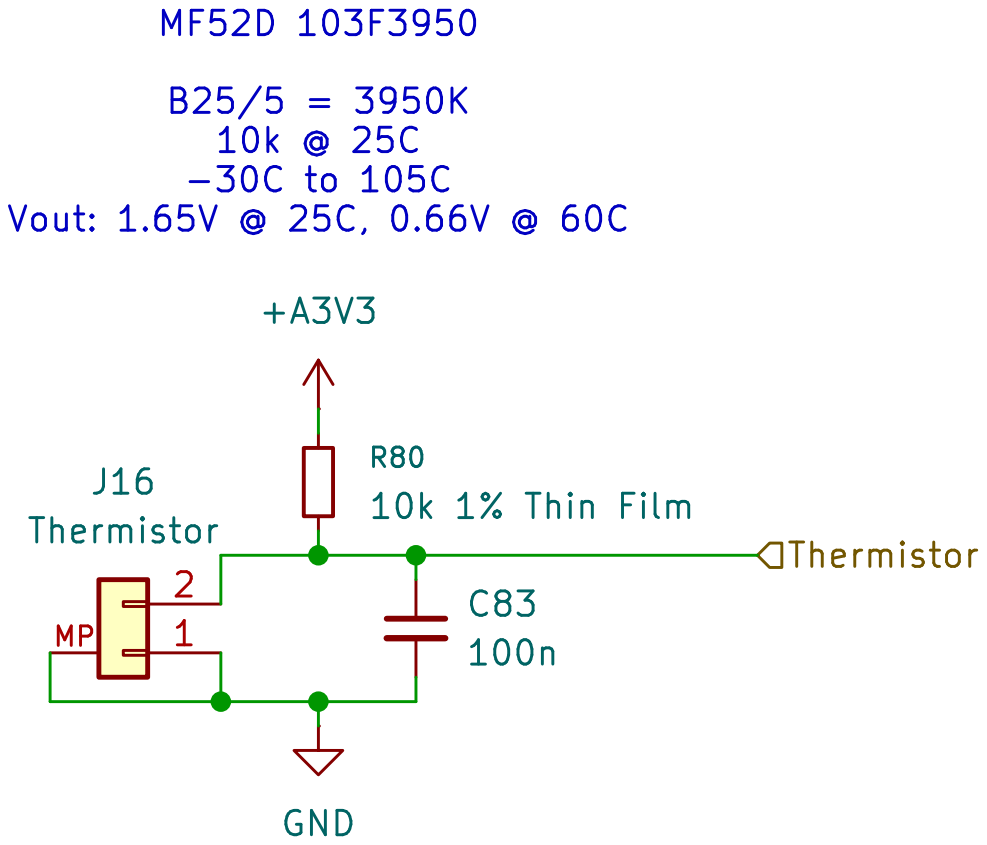
[picture p26: page 26]

Id: 26/30 Title: File: ExtThermistor.kicad_sch Sheet: /Temperature/ExtThermistor9/

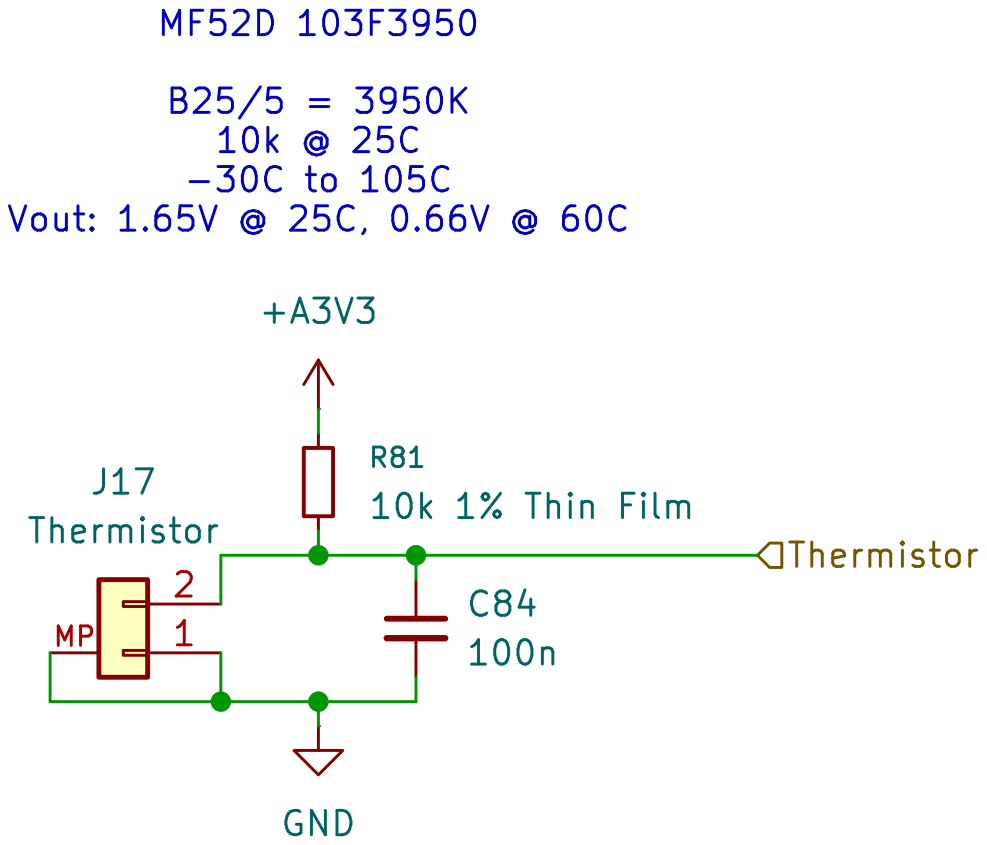
[picture p27: page 27]

Id: 27/30 Title: File: ExtThermistor.kicad_sch Sheet: /Temperature/ExtThermistor10/

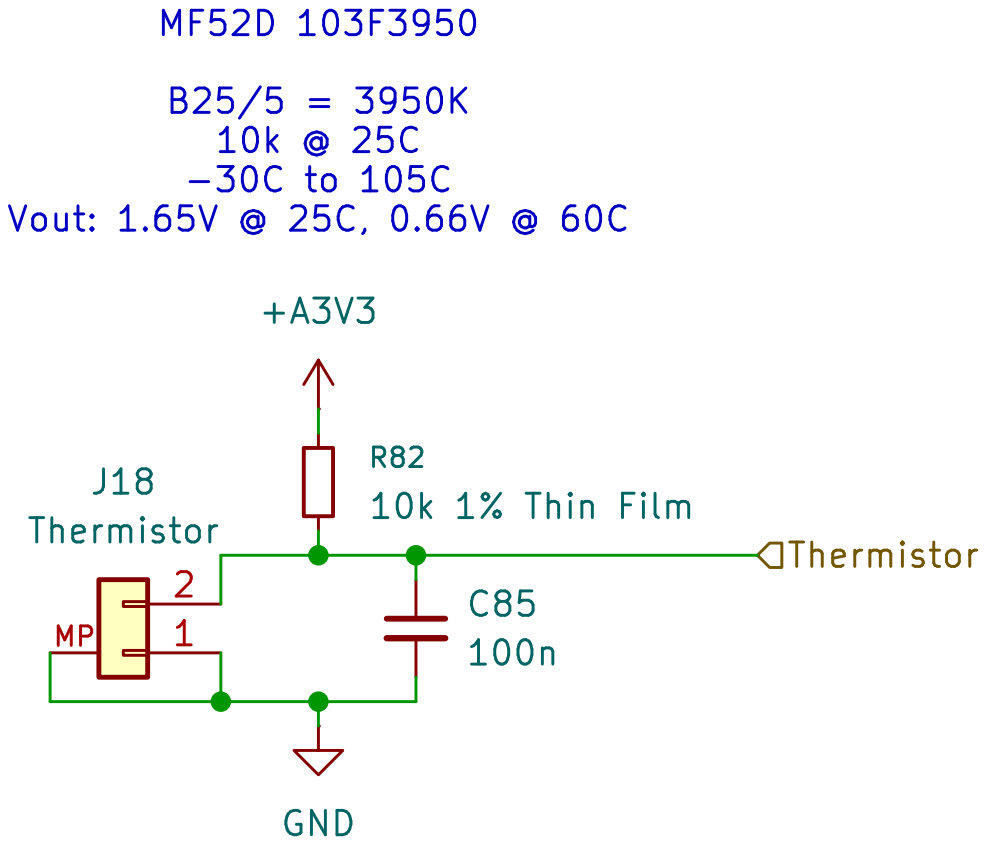
[picture p28: page 28]

Id: 28/30 Title: File: ExtThermistor.kicad_sch Sheet: /Temperature/ExtThermistor11/

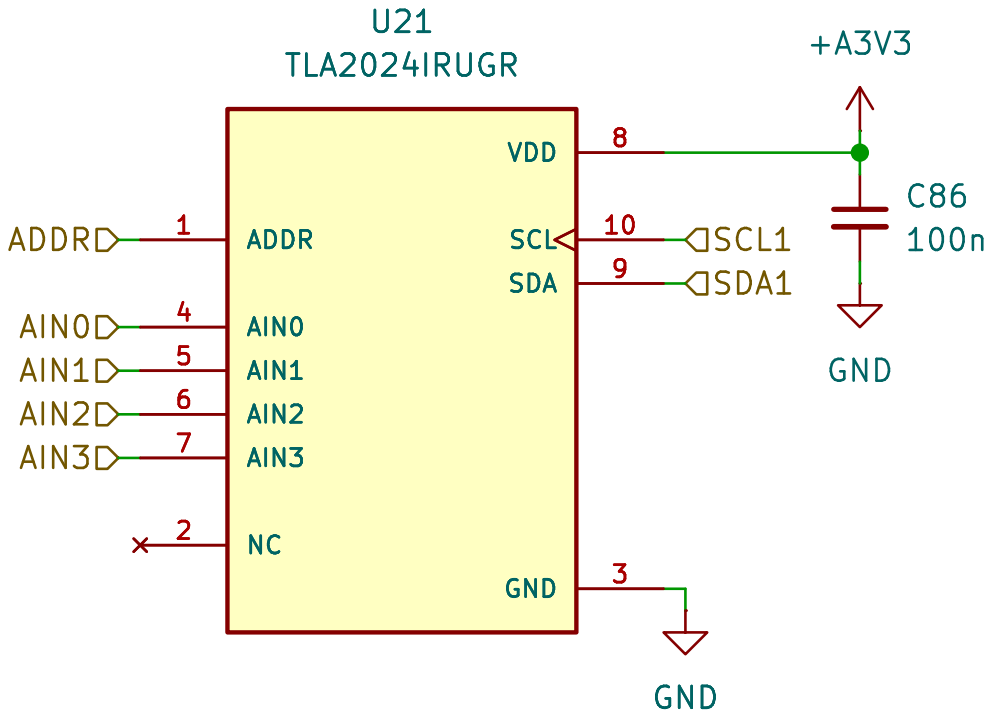
[picture p29: page 29]

Id: 29/30 Title: File: ExtThermistorADC.kicad_sch Sheet: /Temperature/ExtThermistorADC2/

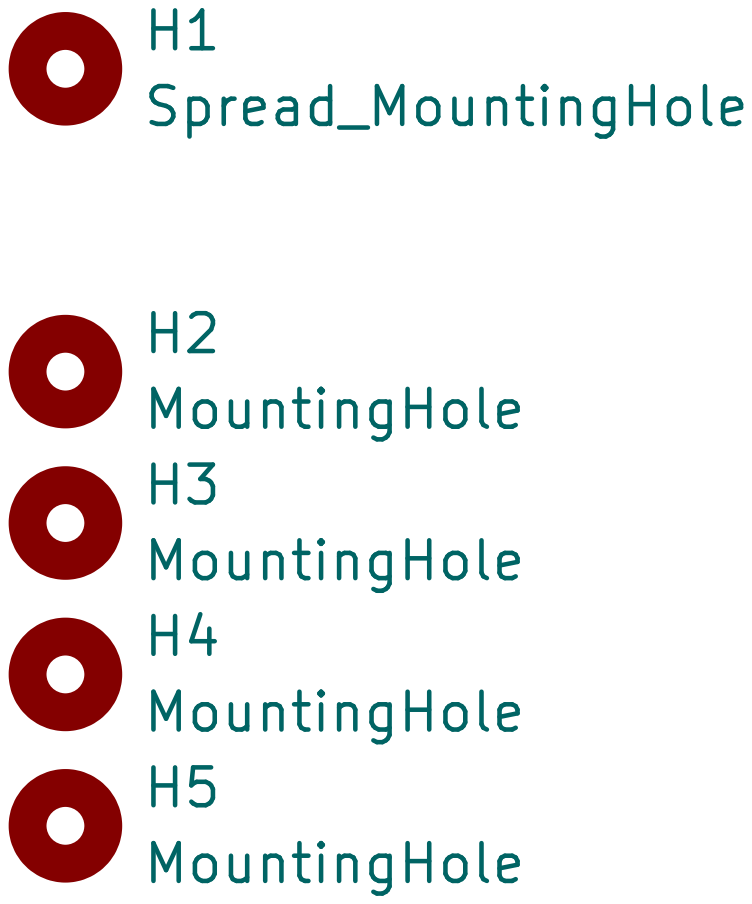
[picture p30: page 30]

Id: 30/30 Title: File: Mechanical.kicad_sch Sheet: /Mechanical/ H5 MountingHole H2 MountingHole H3 MountingHole H4 MountingHole H1Spread_MountingHole
