IWong29/batterycharacterization/BatteryTesterV2.1.kicad_pcb

## KiCad design BatteryTesterV2.1.kicad_pcb (2026-10-12)

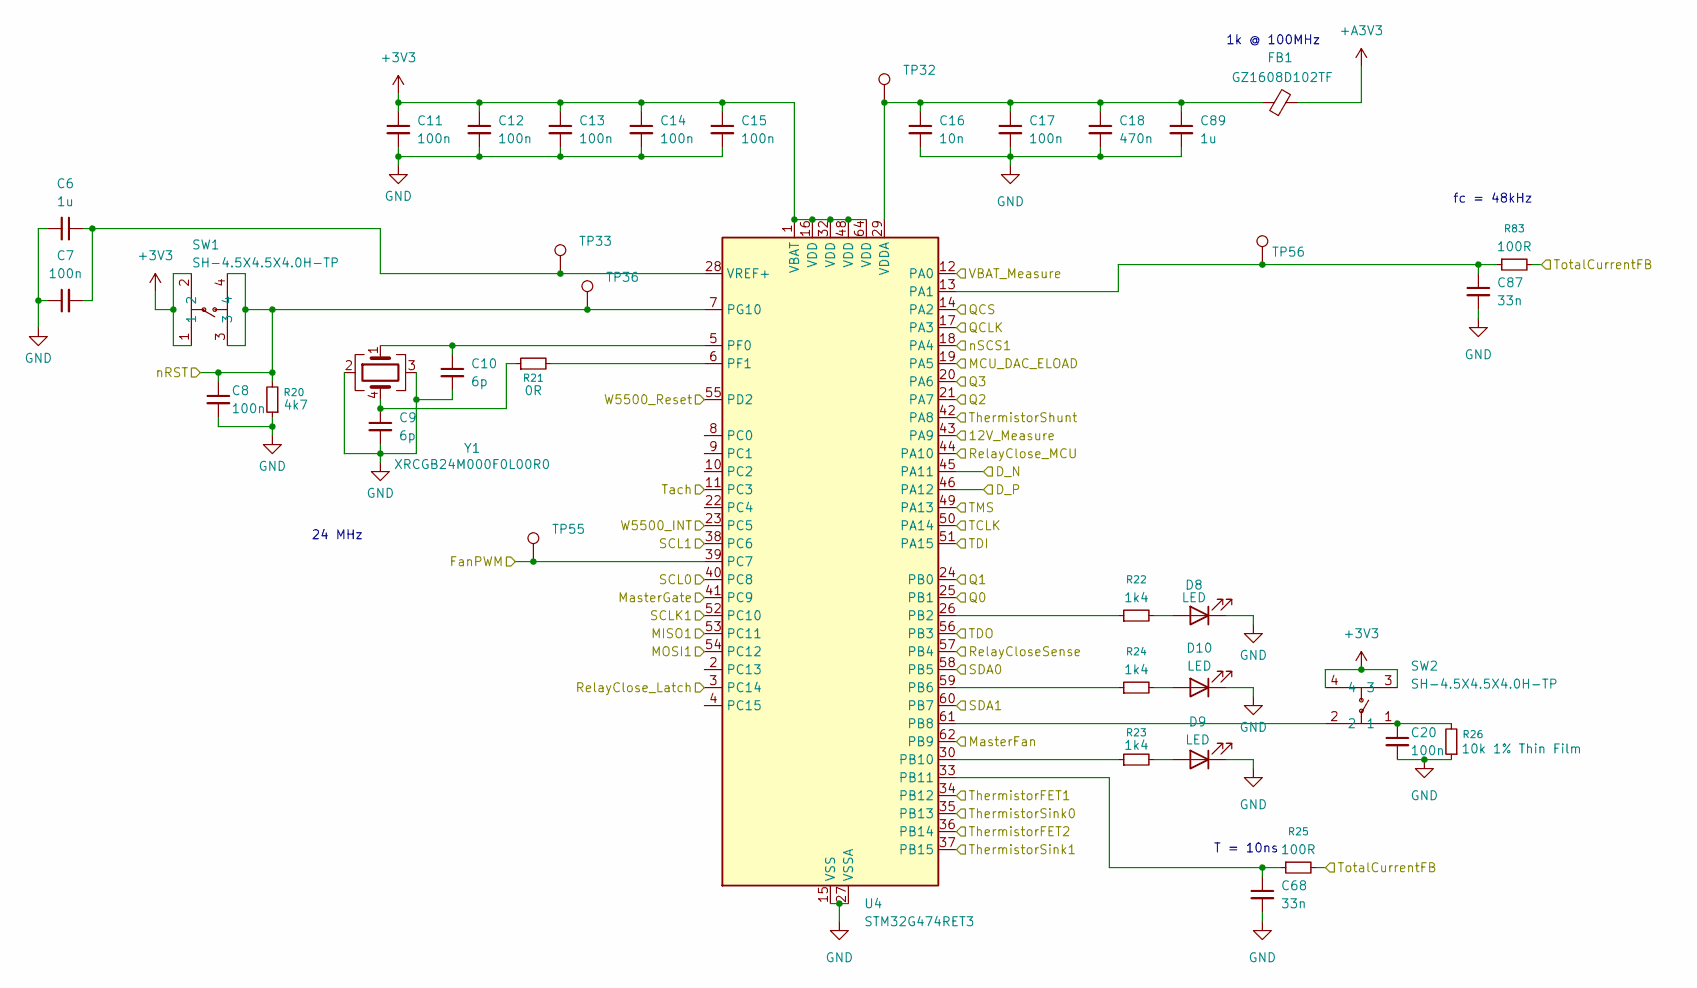
[picture p31: schematic MCU.kicad_sch]

Parts:
C6, C89: 1u; C_0603_1608Metric
C7, C11, C12, C13, C14, C15, C17: 100n; C_0603_1608Metric
C8, C20: 100n; C_0402_1005Metric
C9, C10: 6p; C_0402_1005Metric
C16: 10n; C_0603_1608Metric
C18: 470n; C_0603_1608Metric
C68, C87: 33n; C_0603_1608Metric
D8, D9, D10: LED; D_0603_1608Metric
FB1: GZ1608D102TF; C_0603_1608Metric
R20: 4k7; R_0603_1608Metric
R21: 0R; R_0603_1608Metric
R22, R23, R24: 1k4; R_0603_1608Metric
R25, R83: 100R; R_0603_1608Metric
R26: 10k 1% Thin Film; R_0603_1608Metric
SW1, SW2: SH-4.5X4.5X4.0H-TP; SW-SMD_4P-SH-4.5X4.5X4.0H-TP; MPN SH-4.5x4.5x4.0H-TP; LCSC Part C52092029
TP32, TP33, TP36, TP55, TP56: TestPoint; TestPoint_Pad_D1.0mm
U4: STM32G474RET3; LQFP-64_10x10mm_P0.5mm
Y1: XRCGB24M000F0L00R0

Connections:
+3V3: C11.1, C12.1, C13.1, C14.1, C15.1, SW1.1, SW1.2, SW2.3, SW2.4, U4.1 (VBAT), U4.16 (VDD), U4.32 (VDD), U4.48 (VDD), U4.64 (VDD); also elsewhere on the board
+A3V3: FB1.2; also elsewhere on the board
/BatteryV2/MasterGate: U4.41 (PC9); also elsewhere on the board
/BatteryV2/RelayCloseOut: U4.57 (PB4); also elsewhere on the board
/BatteryV2/RelayClose_Latch: U4.3 (PC14); also elsewhere on the board
/BatteryV2/RelayClose_MCU: U4.44 (PA10); also elsewhere on the board
/Connectors/D_N: U4.45 (PA11); also elsewhere on the board
/Connectors/D_P: U4.46 (PA12); also elsewhere on the board
/Connectors/Fan_PWM: TP55.1, U4.39 (PC7); also elsewhere on the board
/Connectors/MasterFan: U4.62 (PB9); also elsewhere on the board
/Connectors/TCLK: U4.50 (PA14); also elsewhere on the board
/Connectors/TDI: U4.51 (PA15); also elsewhere on the board
/Connectors/TDO: U4.56 (PB3); also elsewhere on the board
/Connectors/TMS: U4.49 (PA13); also elsewhere on the board
/Connectors/Tach: U4.11 (PC3); also elsewhere on the board
/Connectors/nRST: C8.1, R20.2, SW1.3, SW1.4, TP36.1, U4.7 (PG10); also elsewhere on the board
/ELOAD/MCU_DAC_ELOAD: U4.19 (PA5); also elsewhere on the board
/ELOAD/ThermistorSink0: U4.35 (PB13); also elsewhere on the board
/ELOAD/ThermistorSink1: U4.37 (PB15); also elsewhere on the board
/MCU/12V_Measure: U4.43 (PA9); also elsewhere on the board
/MCU/MISO1: U4.53 (PC11); also elsewhere on the board
/MCU/MOSI1: U4.54 (PC12); also elsewhere on the board
/MCU/Q0: U4.25 (PB1); also elsewhere on the board
/MCU/Q1: U4.24 (PB0); also elsewhere on the board
/MCU/Q2: U4.21 (PA7); also elsewhere on the board
/MCU/Q3: U4.20 (PA6); also elsewhere on the board
/MCU/QCLK: U4.17 (PA3); also elsewhere on the board
/MCU/QCS: U4.14 (PA2); also elsewhere on the board
/MCU/SCL0: U4.40 (PC8)
/MCU/SCL1: U4.38 (PC6); also elsewhere on the board
/MCU/SCLK1: U4.52 (PC10); also elsewhere on the board
/MCU/SDA0: U4.58 (PB5)
/MCU/SDA1: U4.60 (PB7); also elsewhere on the board
/MCU/ThermistorFET1: U4.34 (PB12); also elsewhere on the board
/MCU/ThermistorFET2: U4.36 (PB14); also elsewhere on the board
/MCU/ThermistorShunt: U4.42 (PA8); also elsewhere on the board
/MCU/TotalCurrentFB: R25.2, R83.2; also elsewhere on the board
/MCU/VBAT_Measure: U4.12 (PA0); also elsewhere on the board
/MCU/W5500_INT: U4.23 (PC5); also elsewhere on the board
/MCU/W5500_Reset: U4.55 (PD2); also elsewhere on the board
/MCU/nSCS1: U4.18 (PA4); also elsewhere on the board
GND: C6.2, C7.1, C8.2, C9.2, C10.2, C11.2, C12.2, C13.2, C14.2, C15.2, C16.2, C17.2, C18.2, C20.2, C68.2, C87.2, C89.2, D8.1 (K), D9.1 (K), D10.1 (K), R20.1, R26.1, U4.15 (VSS), U4.27 (VSSA), U4.31 (VSS), U4.47 (VSS), U4.63 (VSS), Y1.2, Y1.3; also elsewhere on the board
unnamed: C9.1, R21.1, Y1.4
unnamed: C20.1, R26.2, SW2.1
unnamed: D8.2 (A), R22.2
unnamed: D9.2 (A), R23.2
unnamed: D10.2 (A), R24.2
unnamed: C87.1, R83.1, TP56.1, U4.13 (PA1)
unnamed: R22.1, U4.26 (PB2)
unnamed: R24.1, U4.59 (PB6)
unnamed: SW2.2, U4.61 (PB8)
unnamed: R23.1, U4.30 (PB10)
unnamed: C68.1, R25.1, U4.33 (PB11)
unnamed: C10.1, U4.5 (PF0), Y1.1
unnamed: R21.2, U4.6 (PF1)
unnamed: C16.1, C17.1, C18.1, C89.1, FB1.1, TP32.1, U4.29 (VDDA)
unnamed: C6.1, C7.2, TP33.1, U4.28 (VREF+)

Notes on the sheet:
24 MHz
fc = 48kHz
T = 10ns
1k @ 100MHz

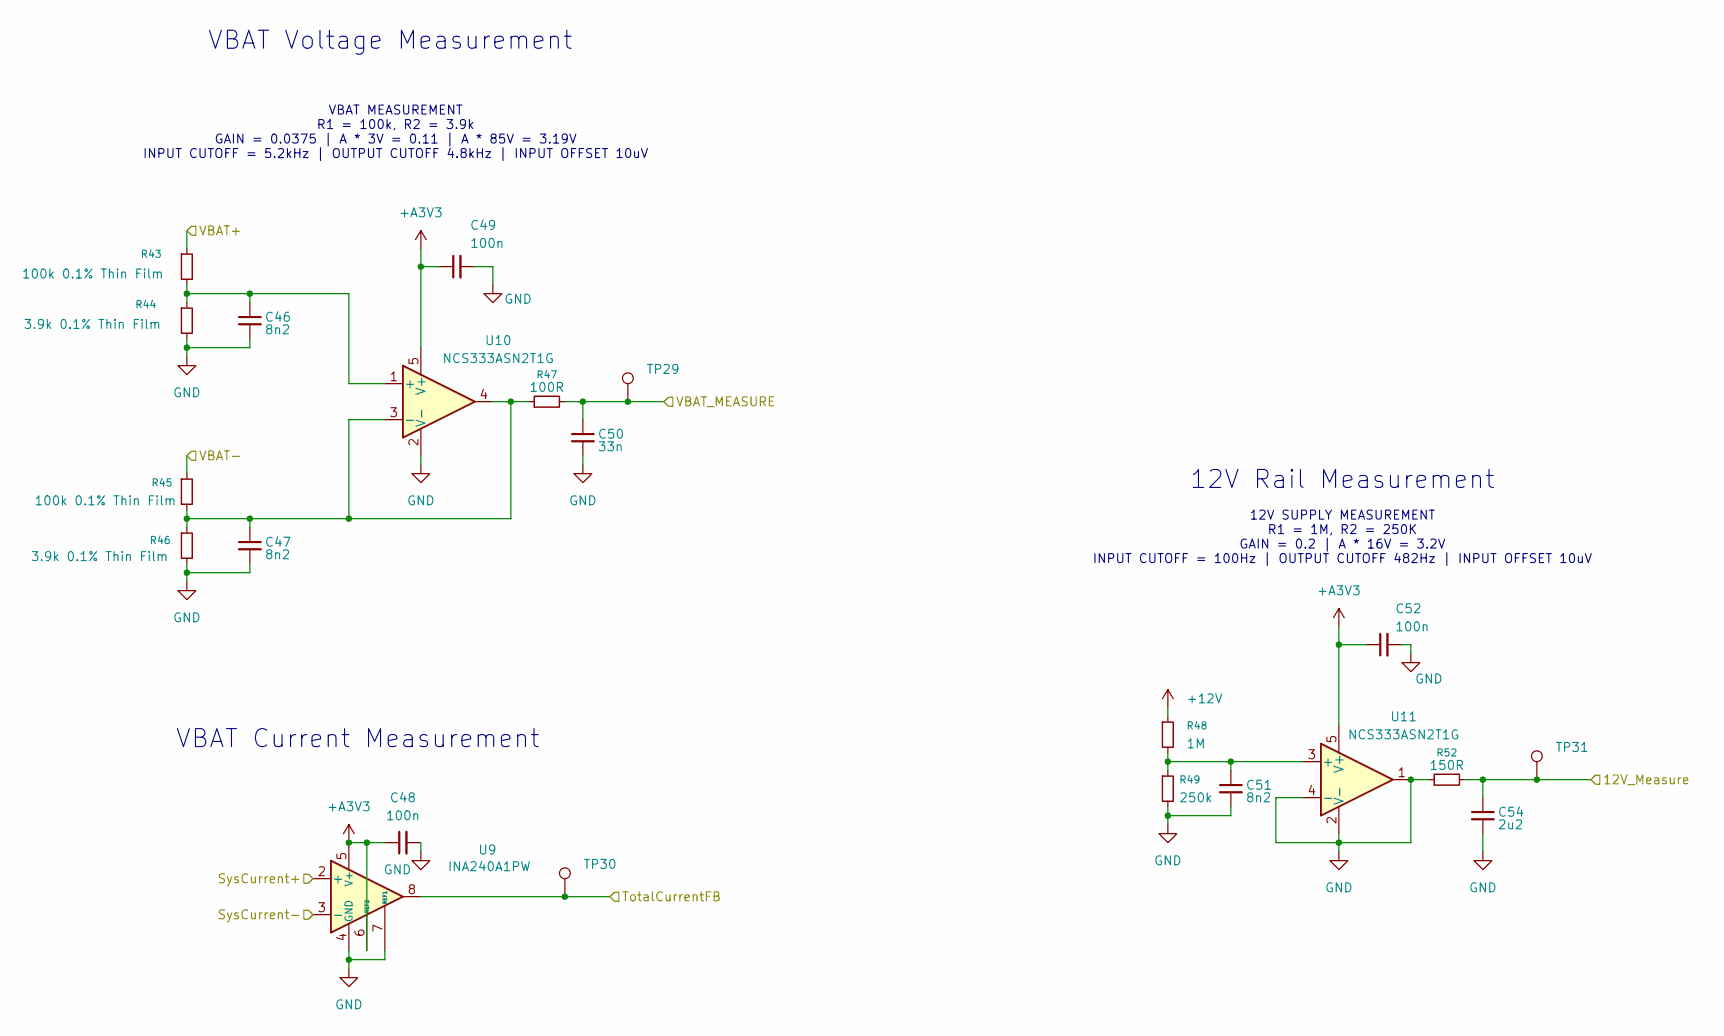
[picture p32: schematic Sensing.kicad_sch]

Parts:
C46, C47, C51: 8n2; C_0603_1608Metric
C48, C49, C52: 100n; C_0603_1608Metric
C50: 33n; C_0603_1608Metric
C54: 2u2; C_0603_1608Metric
R43, R45: 100k 0.1% Thin Film; C_1206_3216Metric
R44, R46: 3.9k 0.1% Thin Film; C_1206_3216Metric
R47: 100R; R_0603_1608Metric
R48: 1M; C_1206_3216Metric
R49: 250k; C_1206_3216Metric
R52: 150R; R_0603_1608Metric
TP29, TP30, TP31: TestPoint; TestPoint_Pad_D1.0mm
U9: INA240A1PW; TSSOP-8_4.4x3mm_P0.65mm
U10, U11: NCS333ASN2T1G; SOT-23-5_HandSoldering

Connections:
+12V: R48.1; also elsewhere on the board
+A3V3: C48.1, C49.1, C52.1, U9.5 (V+), U9.6 (REF2), U10.5 (V+), U11.5 (V+); also elsewhere on the board
+VBAT: R43.1; also elsewhere on the board
-BATT: R45.1; also elsewhere on the board
/BatteryV2/SysCurrent+: U9.2 (+); also elsewhere on the board
/BatteryV2/SysCurrent-: U9.3 (-); also elsewhere on the board
/MCU/12V_Measure: C54.1, R52.2, TP31.1; also elsewhere on the board
/MCU/TotalCurrentFB: TP30.1, U9.8; also elsewhere on the board
/MCU/VBAT_Measure: C50.1, R47.2, TP29.1; also elsewhere on the board
GND: C46.2, C47.2, C48.2, C49.2, C50.2, C51.2, C52.2, C54.2, R44.2, R46.2, R49.2, R52.1, U9.1 (GND), U9.4 (GND), U9.7 (REF1), U10.2 (V-), U11.1, U11.2 (V-), U11.4 (-); also elsewhere on the board
unnamed: C46.1, R43.2, R44.1, U10.1 (+)
unnamed: C47.1, R45.2, R46.1, R47.1, U10.3 (-), U10.4
unnamed: C51.1, R48.2, R49.1, U11.3 (+)

Notes on the sheet:
12V Rail Measurement
VBAT MEASUREMENT R1 = 100k, R2 = 3.9k GAIN = 0.0375 | A * 3V = 0.11 | A * 85V = 3.19V INPUT CUTOFF = 5.2kHz | OUTPUT CUTOFF 4.8kHz | INPUT OFFSET 10uV
12V SUPPLY MEASUREMENT R1 = 1M, R2 = 250K GAIN = 0.2 | A * 16V = 3.2V INPUT CUTOFF = 100Hz | OUTPUT CUTOFF 482Hz | INPUT OFFSET 10uV
VBAT Voltage Measurement
VBAT Current Measurement

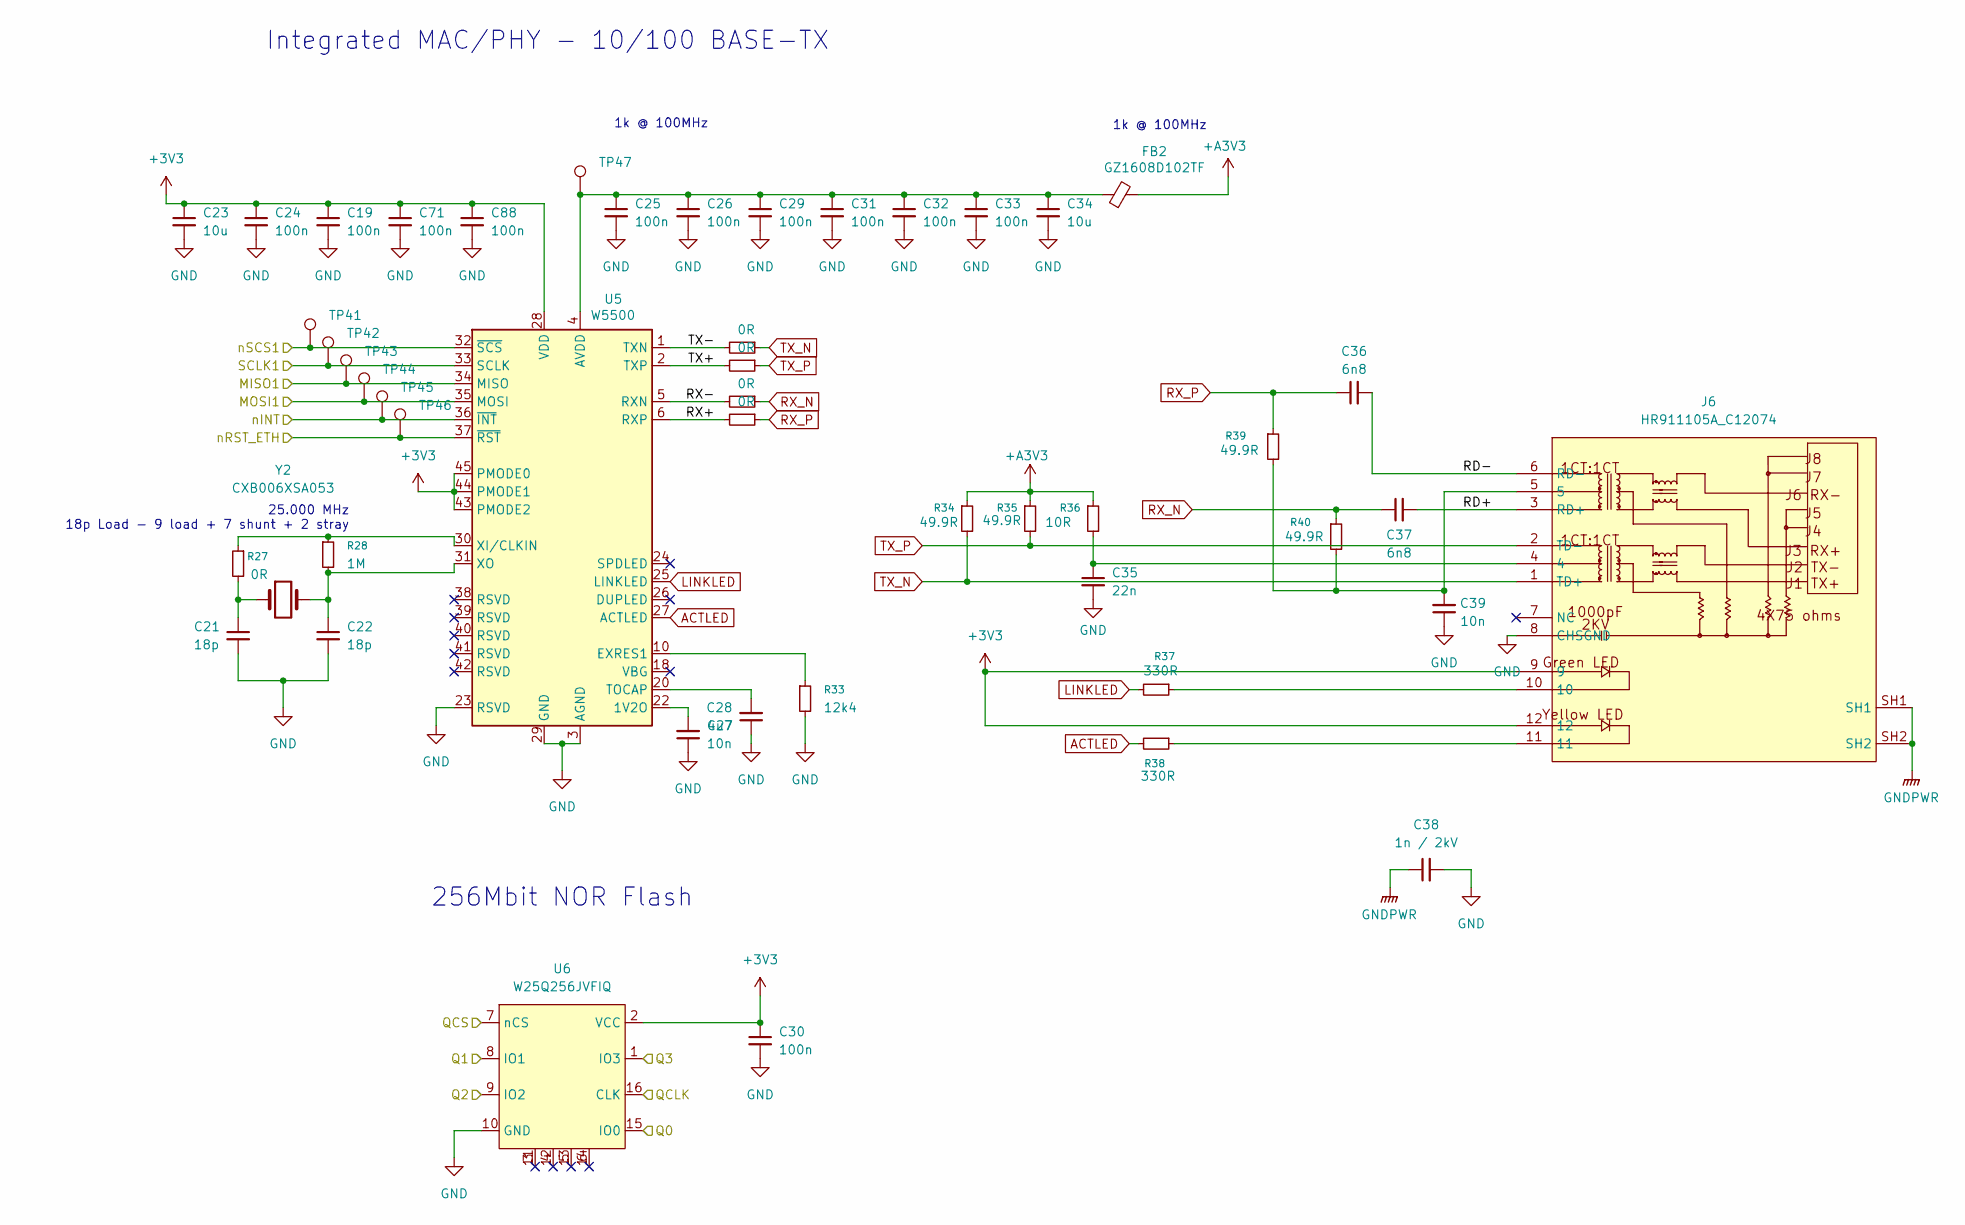
[picture p33: schematic Peripherals.kicad_sch]

Parts:
C19, C24, C25, C26, C29, C30, C31, C32, C33, C71, C88: 100n; C_0603_1608Metric
C21, C22: 18p; C_0402_1005Metric
C23, C34: 10u; C_1206_3216Metric
C27, C39: 10n; C_0603_1608Metric
C28: 4u7; C_0805_2012Metric
C35: 22n; C_0603_1608Metric
C36, C37: 6n8; C_0603_1608Metric
C38: 1n / 2kV; C_1206_3216Metric
FB2: GZ1608D102TF; C_0603_1608Metric
J6: HR911105A_C12074; RJ45-TH_HR911105A; MPN HR911105A; LCSC Part C12074
R27, R29, R30, R31, R32: 0R; R_0603_1608Metric
R28: 1M; C_1206_3216Metric
R33: 12k4; R_0603_1608Metric
R34, R35, R39, R40: 49.9R; R_0603_1608Metric
R36: 10R; R_0603_1608Metric
R37, R38: 330R; R_0603_1608Metric
TP41, TP42, TP43, TP44, TP45, TP46, TP47: TestPoint; TestPoint_Pad_D1.0mm
U5: W5500; LQFP-48_7x7mm_P0.5mm
U6: W25Q256JVFIQ; SOIC-16_3.9x9.9mm_P1.27mm
Y2: CXB006XSA053; Crystal_SMD_HC49-SD

Connections:
+3V3: C19.1, C23.1, C24.1, C30.1, C71.1, C88.1, J6.9, J6.12, U5.28 (VDD), U5.43 (PMODE2), U5.44 (PMODE1), U5.45 (PMODE0), U6.2 (VCC); also elsewhere on the board
+A3V3: FB2.2, R34.1, R35.1, R36.1; also elsewhere on the board
/MCU/MISO1: TP43.1, U5.34 (MISO); also elsewhere on the board
/MCU/MOSI1: TP44.1, U5.35 (MOSI); also elsewhere on the board
/MCU/Q0: U6.15 (IO0); also elsewhere on the board
/MCU/Q1: U6.8 (IO1); also elsewhere on the board
/MCU/Q2: U6.9 (IO2); also elsewhere on the board
/MCU/Q3: U6.1 (IO3); also elsewhere on the board
/MCU/QCLK: U6.16 (CLK); also elsewhere on the board
/MCU/QCS: U6.7 (nCS); also elsewhere on the board
/MCU/SCLK1: TP42.1, U5.33 (SCLK); also elsewhere on the board
/MCU/W5500_INT: TP45.1, U5.36 (~INT); also elsewhere on the board
/MCU/W5500_Reset: TP46.1, U5.37 (~RST); also elsewhere on the board
/MCU/nSCS1: TP41.1, U5.32 (~SCS); also elsewhere on the board
/Peripherals/RD+: C37.2, J6.3 (RD+)
/Peripherals/RD-: C36.2, J6.6 (RD-)
/Peripherals/RX+: R32.2, U5.6 (RXP)
/Peripherals/RX-: R31.2, U5.5 (RXN)
/Peripherals/TX+: R30.2, U5.2 (TXP)
/Peripherals/TX-: R29.2, U5.1 (TXN)
ACTLED: R38.2, U5.27 (ACTLED)
GND: C19.2, C21.2, C22.2, C23.2, C24.2, C25.2, C26.2, C27.1, C28.1, C29.2, C30.2, C31.2, C32.2, C33.2, C34.2, C35.2, C38.2, C39.1, C71.2, C88.2, J6.8 (CHSGND), R33.2, U5.3 (AGND), U5.9 (AGND), U5.14 (AGND), U5.16 (AGND), U5.19 (AGND), U5.23 (RSVD), U5.29 (GND), U5.48 (AGND), U6.10 (GND); also elsewhere on the board
GNDPWR: C38.1, J6.SH1, J6.SH2
LINKLED: R37.2, U5.25 (LINKLED)
unnamed: C21.1, R27.2, Y2.1
unnamed: C25.1, C26.1, C29.1, C31.1, C32.1, C33.1, C34.1, FB2.1, TP47.1, U5.4 (AVDD), U5.8 (AVDD), U5.11 (AVDD), U5.15 (AVDD), U5.17 (AVDD), U5.21 (AVDD)
unnamed: C35.1, J6.4, R36.2
unnamed: C39.2, J6.5, R39.2, R40.2
unnamed: J6.10, R37.1
unnamed: J6.11, R38.1
unnamed: C27.2, U5.22 (1V2O)
unnamed: R33.1, U5.10 (EXRES1)
unnamed: C28.2, U5.20 (TOCAP)
unnamed: R27.1, R28.1, U5.30 (XI/CLKIN)
unnamed: C22.1, R28.2, U5.31 (XO), Y2.2
RX_N: C37.1, R31.1, R40.1
RX_P: C36.1, R32.1, R39.1
TX_N: J6.1 (TD+), R29.1, R34.2
TX_P: J6.2 (TD-), R30.1, R35.2

Notes on the sheet:
1k @ 100MHz
Integrated MAC/PHY - 10/100 BASE-TX
256Mbit NOR Flash
25.000 MHz 18p Load - 9 load + 7 shunt + 2 stray

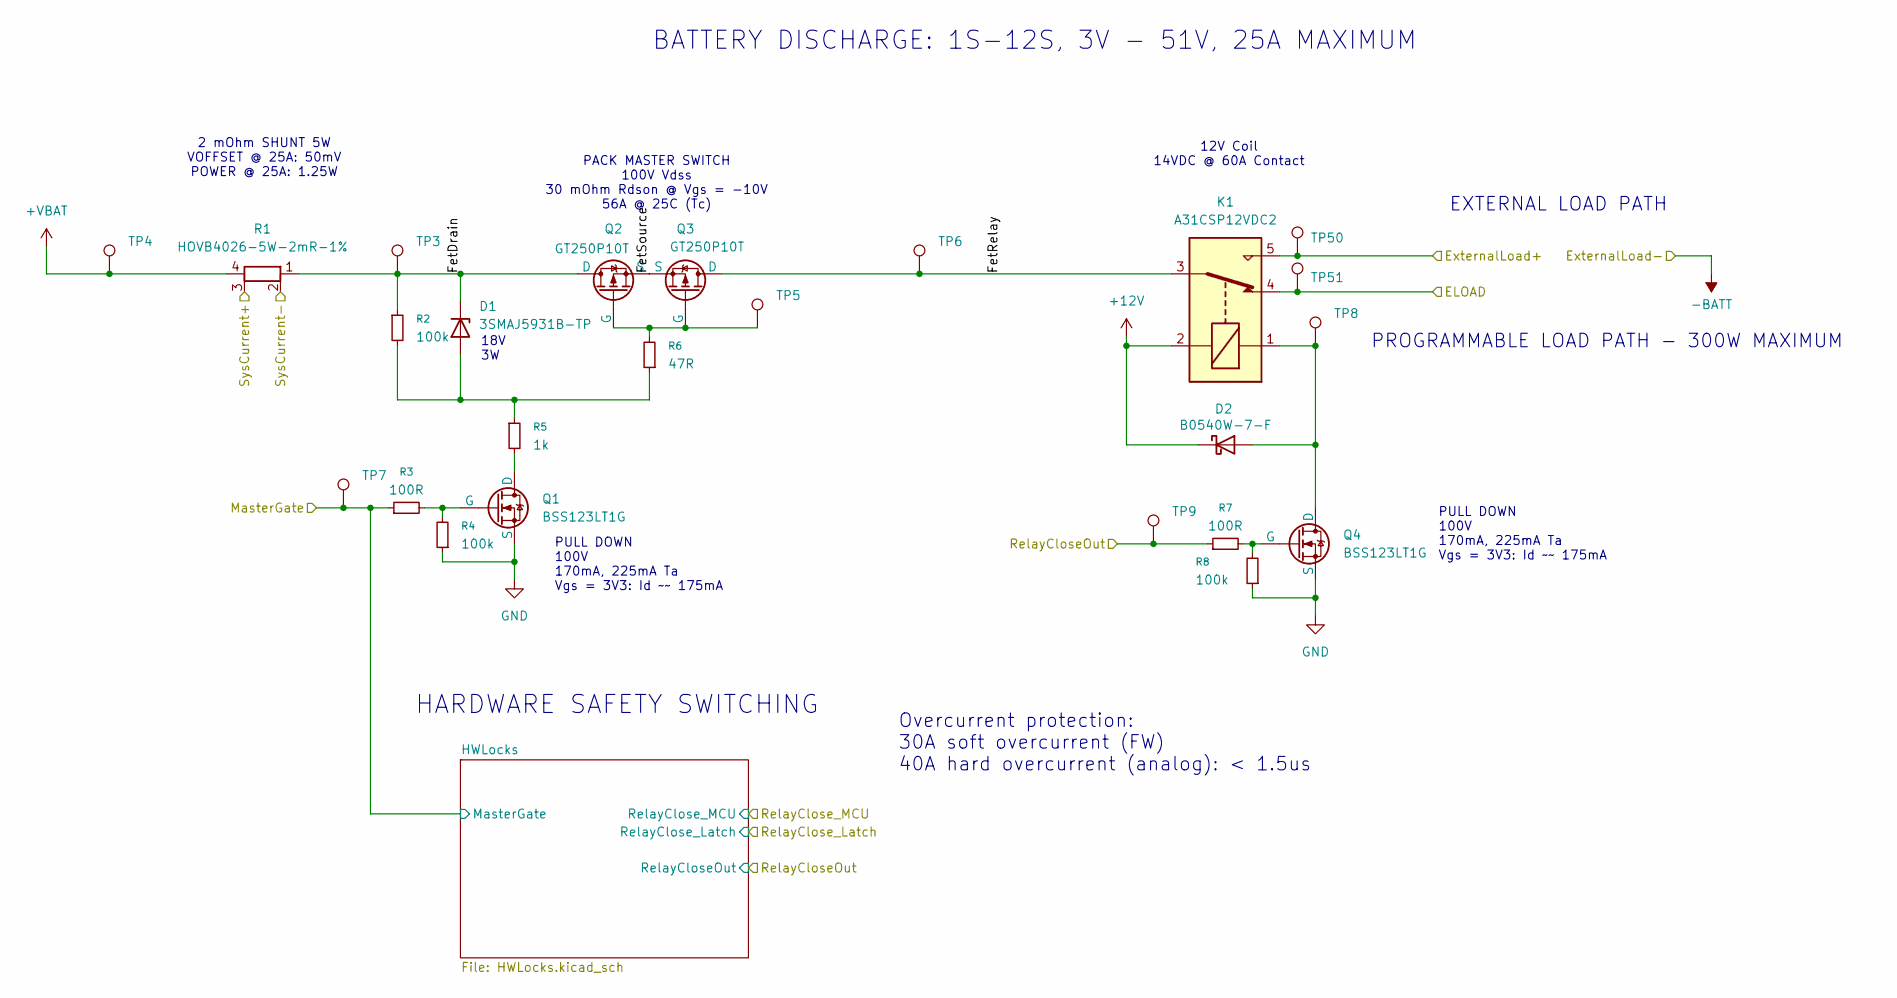
[picture p34: schematic ELoadV2.kicad_sch]

Parts:
D1: 3SMAJ5931B-TP; D_SMA
D2: B0540W-7-F; Nexperia_CFP3_SOD-123W
K1: A31CSP12VDC2
Q1, Q4: BSS123LT1G; SOT-23-3
Q2, Q3: GT250P10T; TO-220 w heatsink
R1: HOVB4026-5W-2mR-1%; R_Shunt_Isabellenhuette_BVR4026
R2, R4, R8: 100k; R_0603_1608Metric
R3, R7: 100R; R_0603_1608Metric
R5: 1k; R_0603_1608Metric
R6: 47R; R_0603_1608Metric
TP3, TP4, TP5, TP6, TP7, TP8, TP9, TP50, TP51: TestPoint; TestPoint_Pad_D1.0mm
U1: (no value)

Connections:
+12V: D2.1 (K), K1.2; also elsewhere on the board
+VBAT: R1.4, TP4.1; also elsewhere on the board
/BatteryV2/ELOAD: K1.4, TP51.1; also elsewhere on the board
/BatteryV2/ExternalLoad+: K1.5, TP50.1; also elsewhere on the board
/BatteryV2/FetDrain: D1.1 (K), Q2.1 (D), R1.1, R2.1, TP3.1
/BatteryV2/FetRelay: K1.3, Q3.1 (D), TP6.1
/BatteryV2/FetSource: Q2.3 (S), Q3.3 (S)
/BatteryV2/MasterGate: R3.1, TP7.1; also elsewhere on the board
/BatteryV2/RelayCloseOut: R7.1, TP9.1; also elsewhere on the board
/BatteryV2/SysCurrent+: R1.3; also elsewhere on the board
/BatteryV2/SysCurrent-: R1.2; also elsewhere on the board
GND: Q1.3 (S), Q4.3 (S), R4.1, R8.1; also elsewhere on the board
unnamed: D1.2 (A), R2.2, R5.1, R6.1
unnamed: D2.2 (A), K1.1, Q4.1 (D), TP8.1
unnamed: Q1.1 (D), R5.2
unnamed: Q1.2 (G), R3.2, R4.2
unnamed: Q2.2 (G), Q3.2 (G), R6.2, TP5.1
unnamed: Q4.2 (G), R7.2, R8.2

Notes on the sheet:
HARDWARE SAFETY SWITCHING
18V 3W
PULL DOWN 100V 170mA, 225mA Ta Vgs = 3V3: Id ~~ 175mA
BATTERY DISCHARGE: 1S-12S, 3V - 51V, 25A MAXIMUM
PACK MASTER SWITCH 100V Vdss 30 mOhm Rdson @ Vgs = -10V 56A @ 25C (Tc)
PROGRAMMABLE LOAD PATH - 300W MAXIMUM
EXTERNAL LOAD PATH
Overcurrent protection: 30A soft overcurrent (FW) 40A hard overcurrent (analog): < 1.5us
2 mOhm SHUNT 5W VOFFSET @ 25A: 50mV POWER @ 25A: 1.25W
12V Coil 14VDC @ 60A Contact

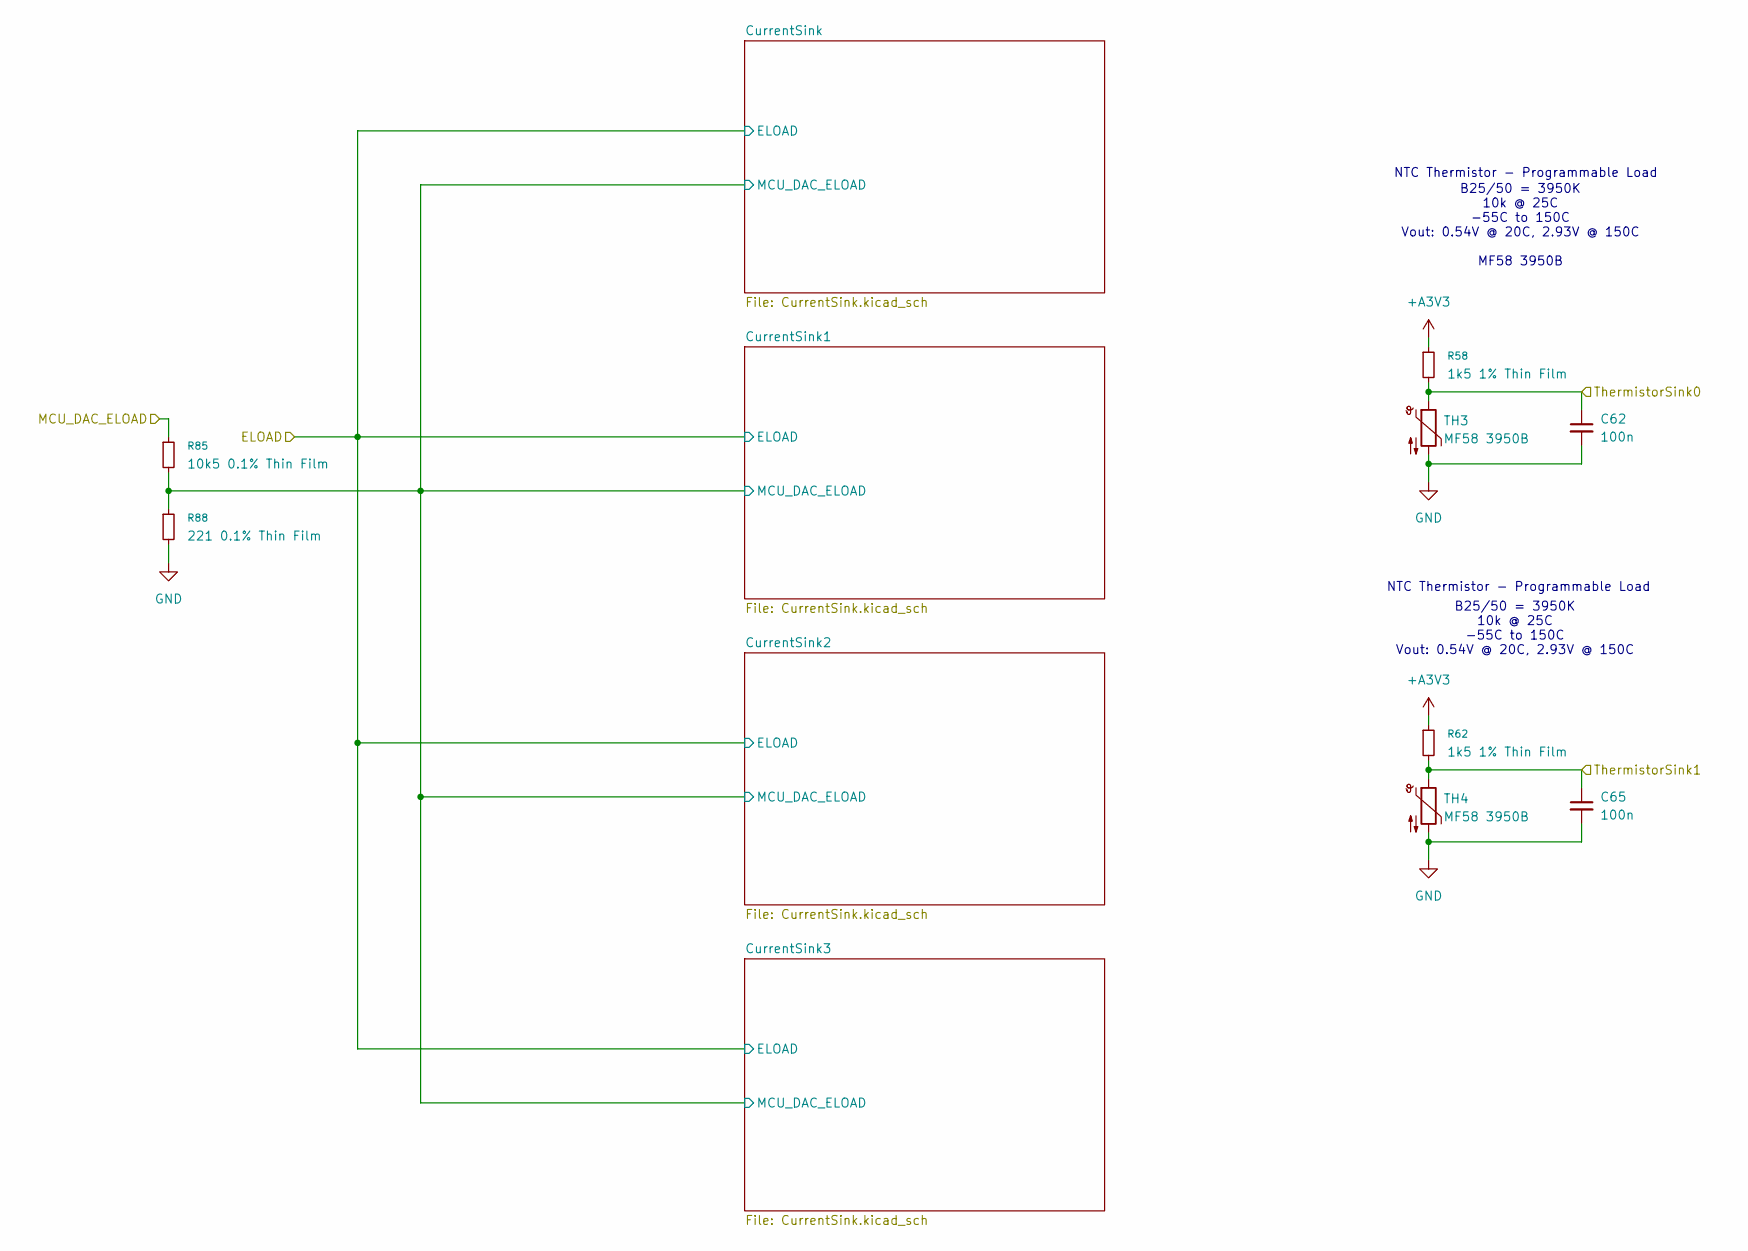
[picture p35: schematic ELOAD.kicad_sch]

Parts:
C62, C65: 100n; C_0603_1608Metric
R58, R62: 1k5 1% Thin Film; R_0603_1608Metric
R85: 10k5 0.1% Thin Film; R_0603_1608Metric
R88: 221 0.1% Thin Film; R_0603_1608Metric
TH3, TH4: MF58 3950B; R_Axial_DIN0204_L3.6mm_D1.6mm_P5.08mm_Vertical

Connections:
+A3V3: R58.1, R62.1; also elsewhere on the board
/ELOAD/CurrentSink/MCU_DAC_ELOAD: R85.2, R88.1; also elsewhere on the board
/ELOAD/MCU_DAC_ELOAD: R85.1; also elsewhere on the board
/ELOAD/ThermistorSink0: C62.1, R58.2, TH3.1; also elsewhere on the board
/ELOAD/ThermistorSink1: C65.1, R62.2, TH4.1; also elsewhere on the board
GND: C62.2, C65.2, R88.2, TH3.2, TH4.2; also elsewhere on the board

Notes on the sheet:
B25/50 = 3950K 10k @ 25C -55C to 150C Vout: 0.54V @ 20C, 2.93V @ 150C
NTC Thermistor - Programmable Load
B25/50 = 3950K 10k @ 25C -55C to 150C Vout: 0.54V @ 20C, 2.93V @ 150C MF58 3950B

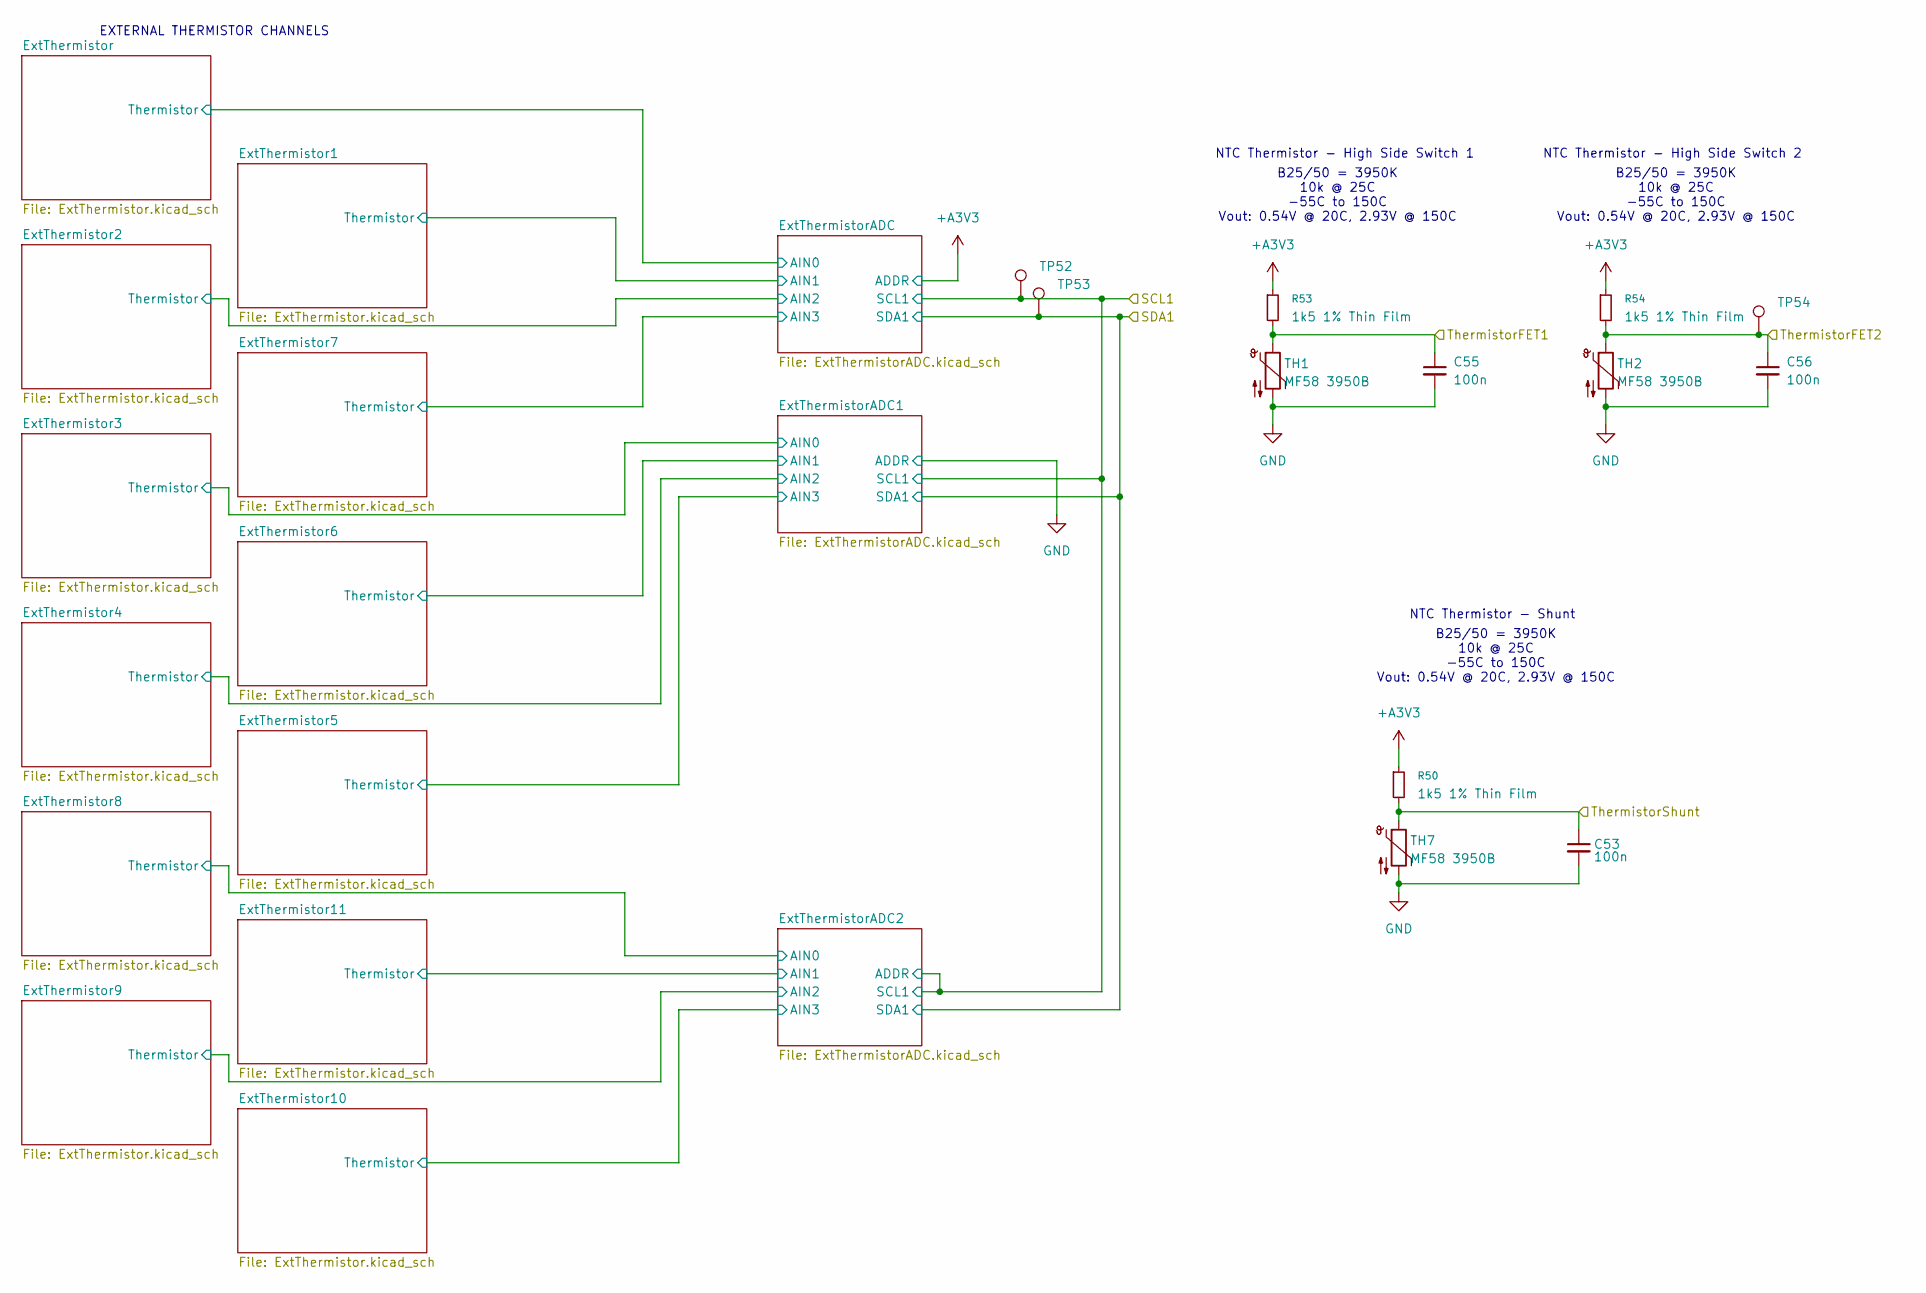
[picture p36: schematic Temperature.kicad_sch]

Parts:
C53, C55, C56: 100n; C_0603_1608Metric
R50, R53, R54: 1k5 1% Thin Film; R_0603_1608Metric
TH1, TH2, TH7: MF58 3950B; R_Axial_DIN0204_L3.6mm_D1.6mm_P5.08mm_Vertical
TP52, TP53, TP54: TestPoint; TestPoint_Pad_D1.0mm

Connections:
+A3V3: R50.1, R53.1, R54.1; also elsewhere on the board
/MCU/SCL1: TP52.1; also elsewhere on the board
/MCU/SDA1: TP53.1; also elsewhere on the board
/MCU/ThermistorFET1: C55.1, R53.2, TH1.1; also elsewhere on the board
/MCU/ThermistorFET2: C56.1, R54.2, TH2.1, TP54.1; also elsewhere on the board
/MCU/ThermistorShunt: C53.1, R50.2, TH7.1; also elsewhere on the board
GND: C53.2, C55.2, C56.2, TH1.2, TH2.2, TH7.2; also elsewhere on the board

Notes on the sheet:
NTC Thermistor - Shunt
B25/50 = 3950K 10k @ 25C -55C to 150C Vout: 0.54V @ 20C, 2.93V @ 150C
NTC Thermistor - High Side Switch 2
EXTERNAL THERMISTOR CHANNELS
NTC Thermistor - High Side Switch 1

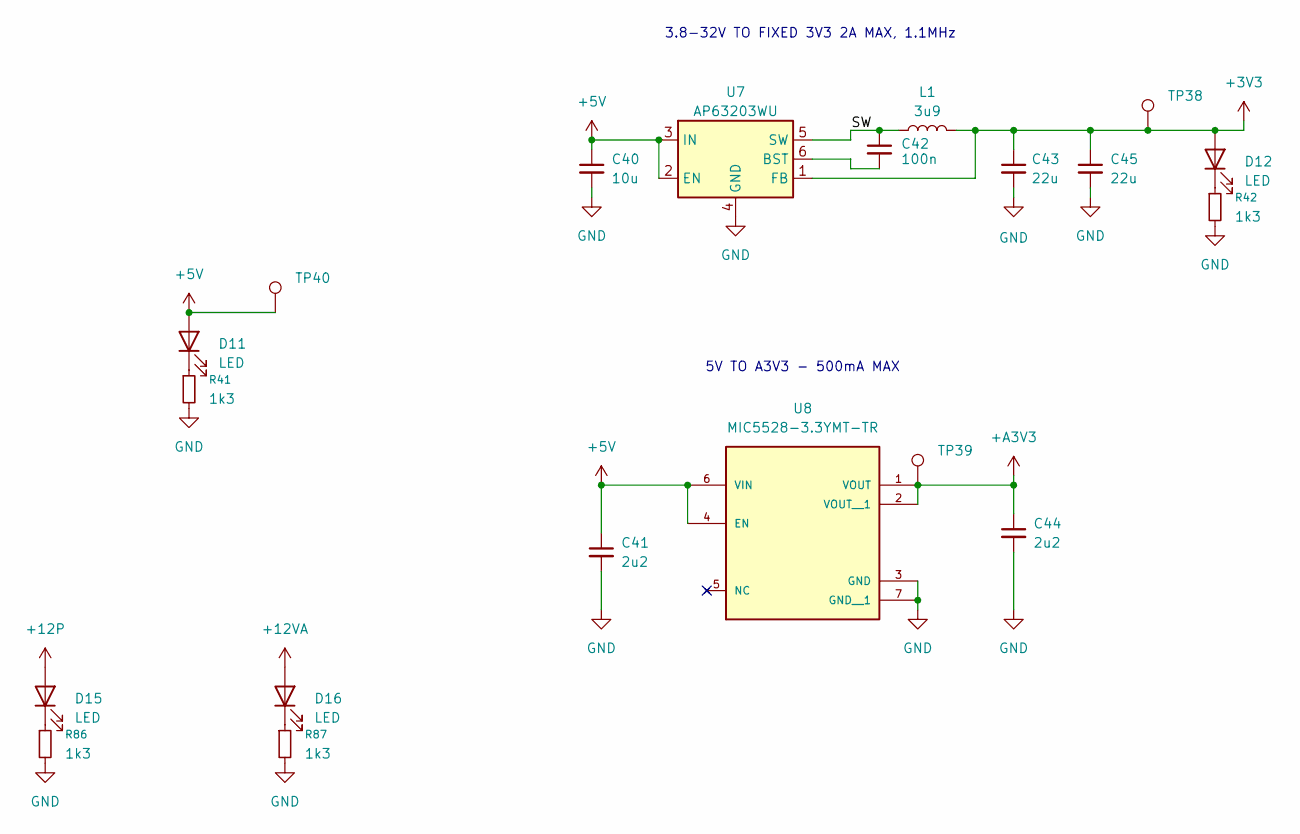
[picture p37: schematic Power.kicad_sch]

Parts:
C40: 10u; C_1206_3216Metric
C41, C44: 2u2; C_0603_1608Metric
C42: 100n; C_0603_1608Metric
C43, C45: 22u; C_1206_3216Metric
D11, D12, D15, D16: LED; D_0603_1608Metric
L1: 3u9; Inductor6.3_5.7_2
R41, R42, R86, R87: 1k3; R_0603_1608Metric
TP38, TP39, TP40: TestPoint; TestPoint_Pad_D1.0mm
U7: AP63203WU; TSOT-23-6
U8: MIC5528-3.3YMT-TR; TDFN-6-1EP_1.2x1.2mm_P0.4mm_EP0.3x0.94mm

Connections:
+3V3: C43.1, C45.1, D12.2 (A), L1.2, TP38.1, U7.1 (FB); also elsewhere on the board
+5V: C40.1, C41.1, D11.2 (A), TP40.1, U7.2 (EN), U7.3 (IN), U8.4 (EN), U8.6 (VIN); also elsewhere on the board
+12P: D15.2 (A); also elsewhere on the board
+12VA: D16.2 (A); also elsewhere on the board
+A3V3: C44.1, TP39.1, U8.1 (VOUT), U8.2 (VOUT__1); also elsewhere on the board
/Power/SW: C42.1, L1.1, U7.5 (SW)
GND: C40.2, C41.2, C43.2, C44.2, C45.2, R41.2, R42.2, R86.2, R87.2, U7.4 (GND), U8.3 (GND), U8.7 (GND__1); also elsewhere on the board
unnamed: D11.1 (K), R41.1
unnamed: D12.1 (K), R42.1
unnamed: D15.1 (K), R86.1
unnamed: D16.1 (K), R87.1
unnamed: C42.2, U7.6 (BST)

Notes on the sheet:
5V TO A3V3 - 500mA MAX
3.8-32V TO FIXED 3V3 2A MAX, 1.1MHz
