IWong29/batterycharacterization/BatteryTesterV2.1.kicad_pcb

## KiCad design BatteryTesterV2.1.kicad_pcb (continued)

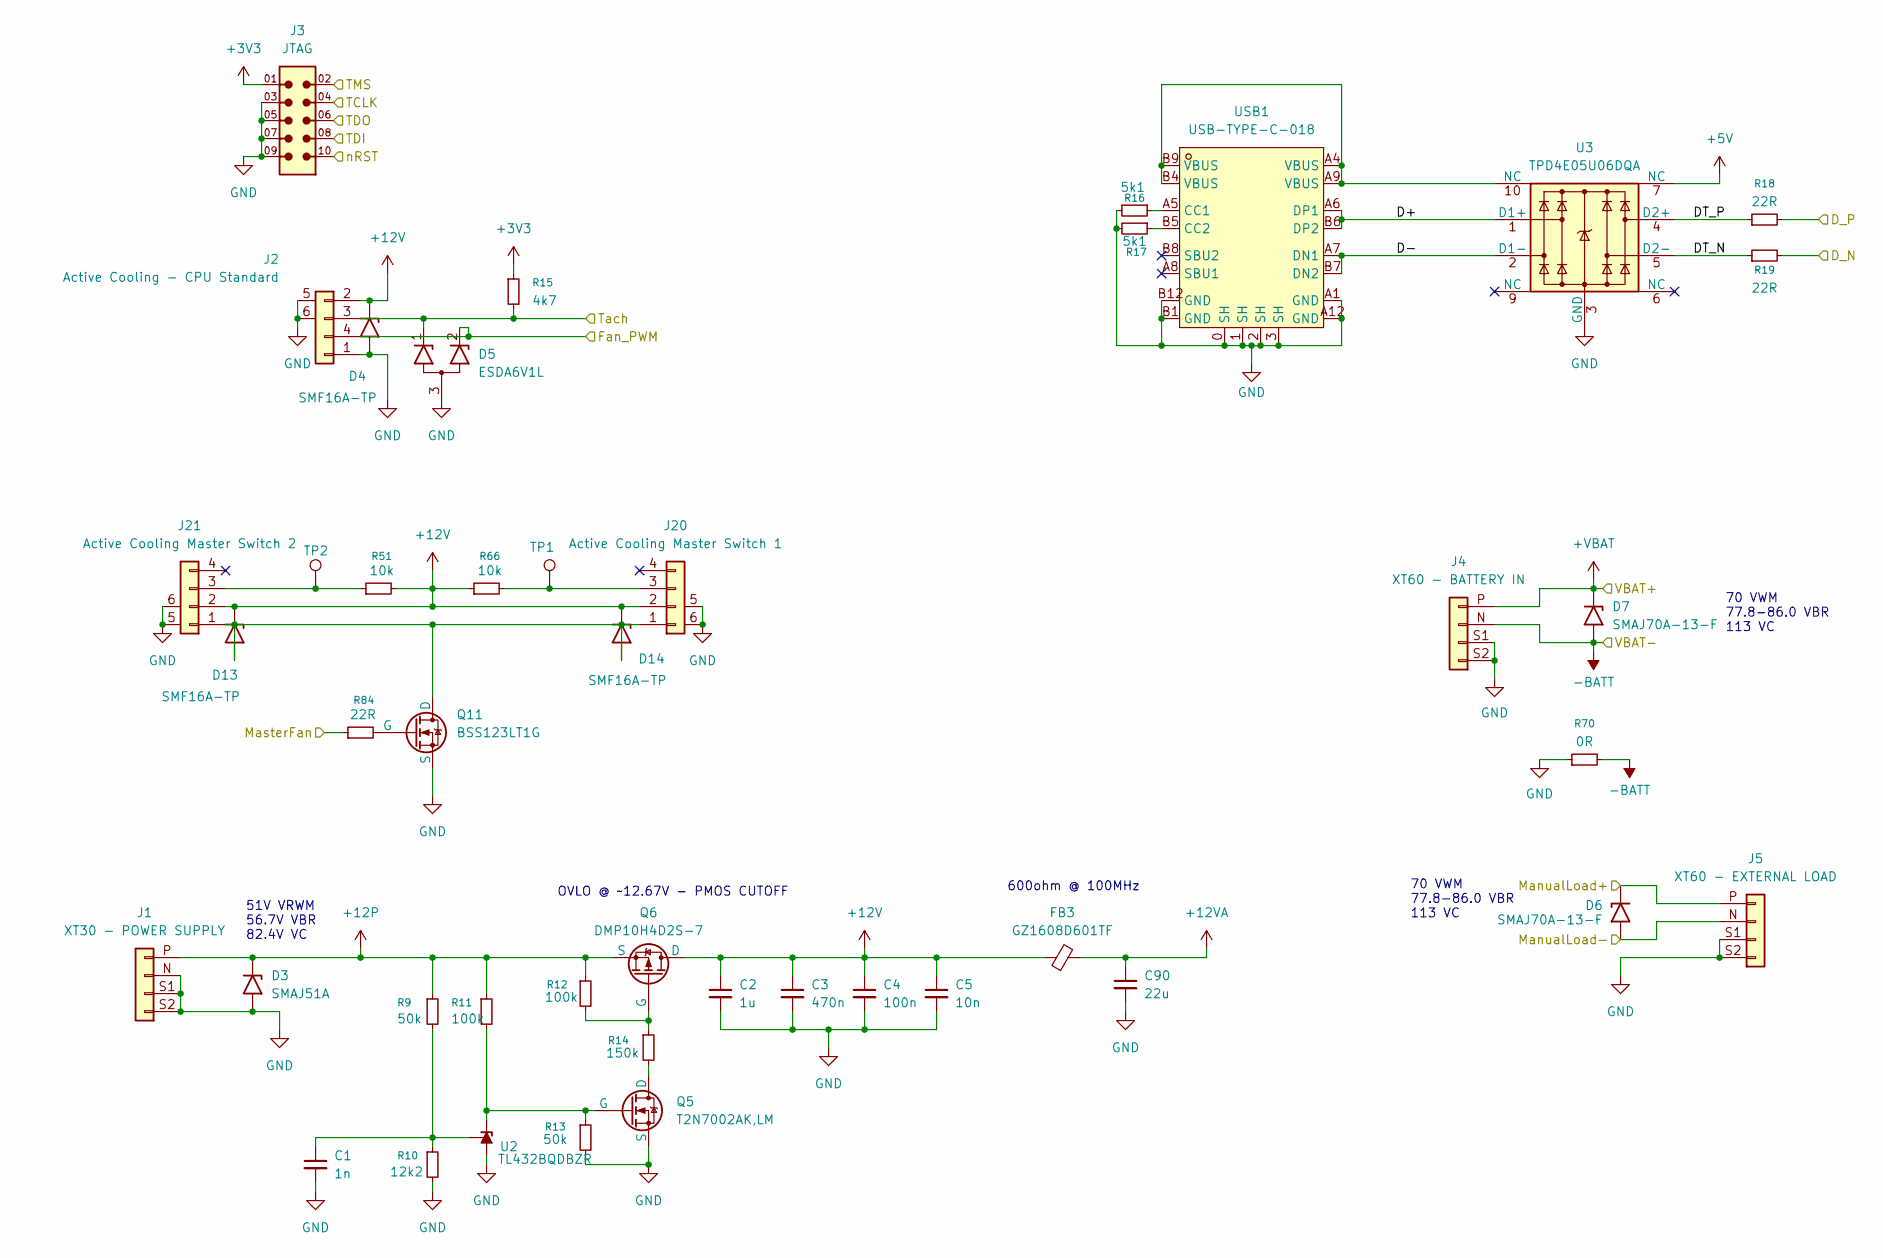
[picture p38: schematic Connectors.kicad_sch]

Parts:
C1: 1n; C_0603_1608Metric
C2: 1u; C_0603_1608Metric
C3: 470n; C_0603_1608Metric
C4: 100n; C_0603_1608Metric
C5: 10n; C_0603_1608Metric
C90: 22u; C_1206_3216Metric
D3: SMAJ51A; D_SMA
D4, D13, D14: SMF16A-TP; D_SMF
D5: ESDA6V1L; SOT-23
D6, D7: SMAJ70A-13-F; D_SMA
FB3: GZ1608D601TF; C_0603_1608Metric
J1: XT30 - POWER SUPPLY; AMASS_XT30PW-M
J2: Active Cooling - CPU Standard; CONN-SMD_4P-P1.00_SM04B-SRSS-TB-LF-SN
J3: JTAG; JTAG_SAMTEC_FTSH-105-01-X-DV-P-K-X
J4: XT60 - BATTERY IN; XT60
J5: XT60 - EXTERNAL LOAD; XT60
J20: Active Cooling Master Switch 1; CONN-SMD_4P-P1.00_SM04B-SRSS-TB-LF-SN
J21: Active Cooling Master Switch 2; CONN-SMD_4P-P1.00_SM04B-SRSS-TB-LF-SN
Q5: T2N7002AK,LM; SOT-23-3
Q6: DMP10H4D2S-7; SOT-23-3
Q11: BSS123LT1G; SOT-23-3
R9, R13: 50k; C_0805_2012Metric
R10: 12k2; R_0603_1608Metric
R11, R12: 100k; R_0603_1608Metric
R14: 150k; R_0603_1608Metric
R15: 4k7; R_0603_1608Metric
R16, R17: 5k1; R_0603_1608Metric
R18, R19: 22R; R_0603_1608Metric
R51, R66: 10k; C_0805_2012Metric
R70: 0R; R_0603_1608Metric
R84: 22R; C_0805_2012Metric
TP1, TP2: TestPoint; TestPoint_Pad_D1.0mm
U2: TL432BQDBZR; SOT-23-3
U3: TPD4E05U06DQA; USON-10_2.5x1.0mm_P0.5mm
USB1: USB-TYPE-C-018; USB-C_SMD-TYPE-C18; MPN USB-TYPE-C-018; LCSC Part C2927038

Connections:
+3V3: J3.01, R15.1; also elsewhere on the board
+5V: U3.7 (NC); also elsewhere on the board
+12P: D3.1 (A1), J1.P (Pin_4), Q6.3 (S), R9.1, R11.1, R12.1; also elsewhere on the board
+12V: C2.1, C3.1, C4.1, C5.1, D4.1 (A1), D13.1 (A1), D14.1 (A1), FB3.1, J2.2, J20.2, J21.2, Q6.1 (D), R51.2, R66.1; also elsewhere on the board
+12VA: C90.1, FB3.2; also elsewhere on the board
+VBAT: D7.1 (A1), J4.P (Pin_4); also elsewhere on the board
-BATT: D6.2 (A2), D7.2 (A2), J4.N (Pin_3), J5.N (Pin_3), R70.2; also elsewhere on the board
/BatteryV2/ExternalLoad+: D6.1 (A1), J5.P (Pin_4); also elsewhere on the board
/Connectors/D+: U3.1 (D1+), USB1.A6 (DP1), USB1.B6 (DP2)
/Connectors/D-: U3.2 (D1-), USB1.A7 (DN1), USB1.B7 (DN2)
/Connectors/DT_N: R19.1, U3.5 (D2-)
/Connectors/DT_P: R18.1, U3.4 (D2+)
/Connectors/D_N: R19.2; also elsewhere on the board
/Connectors/D_P: R18.2; also elsewhere on the board
/Connectors/Fan_PWM: D5.2 (K2), J2.4; also elsewhere on the board
/Connectors/MasterFan: R84.1; also elsewhere on the board
/Connectors/TCLK: J3.04; also elsewhere on the board
/Connectors/TDI: J3.08; also elsewhere on the board
/Connectors/TDO: J3.06; also elsewhere on the board
/Connectors/TMS: J3.02; also elsewhere on the board
/Connectors/Tach: D5.1 (K1), J2.3, R15.2; also elsewhere on the board
/Connectors/nRST: J3.10; also elsewhere on the board
GND: C1.2, C2.2, C3.2, C4.2, C5.2, C90.2, D3.2 (A2), D4.2 (A2), D5.3 (A), J1.N (Pin_3), J1.S1 (Pin_2), J1.S2 (Pin_1), J2.1, J2.5, J2.6, J3.03, J3.05, J3.07, J3.09, J4.S1 (Pin_2), J4.S2 (Pin_1), J5.S1 (Pin_2), J5.S2 (Pin_1), J20.5, J20.6, J21.5, J21.6, Q5.3 (S), Q11.3 (S), R10.2, R13.2, R16.2, R17.2, R70.1, U2.3 (A), U3.3 (GND), U3.8 (GND), USB1.0 (SH), USB1.1 (SH), USB1.2 (SH), USB1.3 (SH), USB1.A1 (GND), USB1.A12 (GND), USB1.B1 (GND), USB1.B12 (GND); also elsewhere on the board
unnamed: D13.2 (A2), D14.2 (A2), J20.1, J21.1, Q11.1 (D)
unnamed: J20.3, R66.2, TP1.1
unnamed: J21.3, R51.1, TP2.1
unnamed: Q5.1 (D), R14.2
unnamed: Q5.2 (G), R11.2, R13.1, U2.1 (K)
unnamed: Q6.2 (G), R12.2, R14.1
unnamed: Q11.2 (G), R84.2
unnamed: C1.1, R9.2, R10.1, U2.2 (REF)
unnamed: U3.10 (NC), USB1.A4 (VBUS), USB1.A9 (VBUS), USB1.B4 (VBUS), USB1.B9 (VBUS)
unnamed: R16.1, USB1.A5 (CC1)
unnamed: R17.1, USB1.B5 (CC2)

Notes on the sheet:
70 VWM 77.8-86.0 VBR 113 VC
600ohm @ 100MHz
51V VRWM 56.7V VBR 82.4V VC
OVLO @ ~12.67V - PMOS CUTOFF

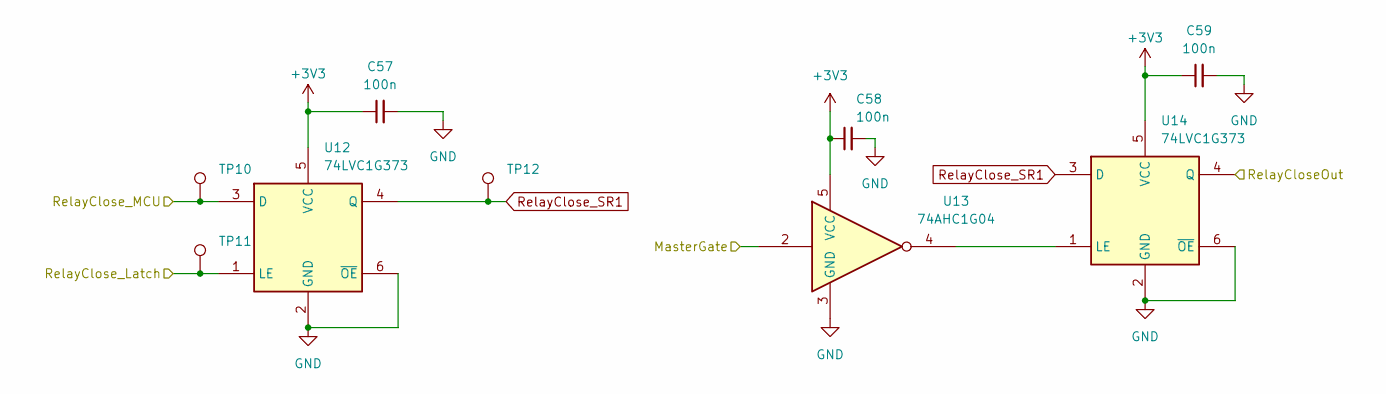
[picture p39: schematic HWLocks.kicad_sch]

Parts:
C57, C58, C59: 100n; C_0603_1608Metric
TP10, TP11, TP12: TestPoint; TestPoint_Pad_D1.0mm
U12, U14: 74LVC1G373; SOT-363_SC-70-6
U13: 74AHC1G04; SOT-353_SC-70-5

Connections:
+3V3: C57.1, C58.1, C59.1, U12.5 (VCC), U13.5 (VCC), U14.5 (VCC); also elsewhere on the board
/BatteryV2/MasterGate: U13.2; also elsewhere on the board
/BatteryV2/RelayCloseOut: U14.4 (Q); also elsewhere on the board
/BatteryV2/RelayClose_Latch: TP11.1, U12.1 (LE); also elsewhere on the board
/BatteryV2/RelayClose_MCU: TP10.1, U12.3 (D); also elsewhere on the board
GND: C57.2, C58.2, C59.2, U12.2 (GND), U12.6 (~OE), U13.3 (GND), U14.2 (GND), U14.6 (~OE); also elsewhere on the board
unnamed: U13.4, U14.1 (LE)
RelayClose_SR1: TP12.1, U12.4 (Q), U14.3 (D)

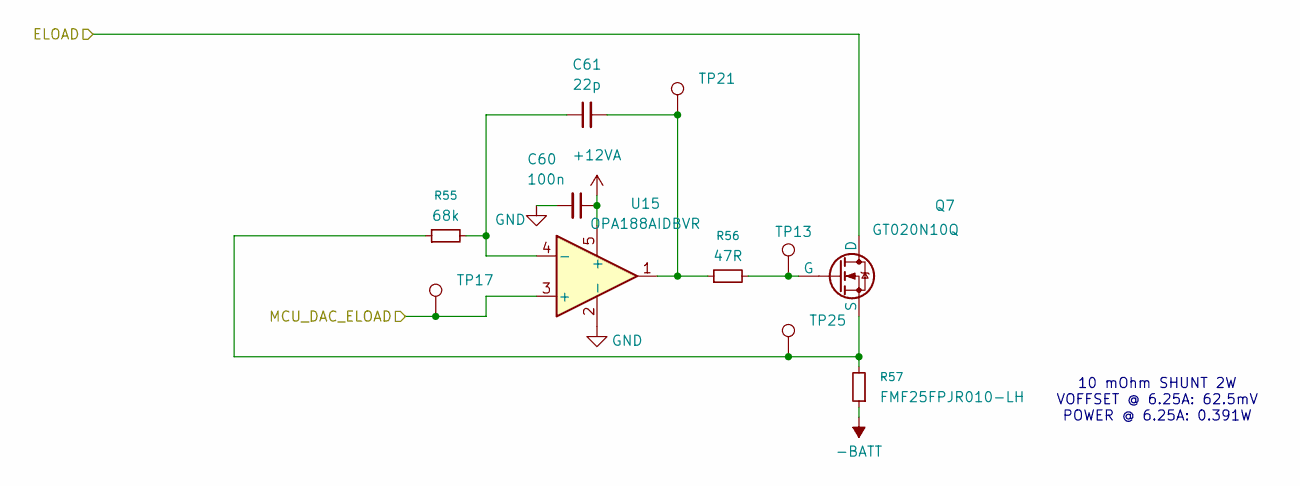
[picture p40: schematic CurrentSink.kicad_sch]

Parts:
C60: 100n; C_0603_1608Metric
C61: 22p; C_0603_1608Metric
Q7: GT020N10Q; TO-247-3_Horizontal_TabUp
R55: 68k; R_0603_1608Metric
R56: 47R; R_0603_1608Metric
R57: FMF25FPJR010-LH; R_2512_6332Metric
TP13, TP17, TP21, TP25: TestPoint; TestPoint_Pad_D1.0mm
U15: OPA188AIDBVR; SOT-23-5

Connections:
+12VA: C60.1, U15.5 (+); also elsewhere on the board
-BATT: R57.1; also elsewhere on the board
/BatteryV2/ELOAD: Q7.1 (D); also elsewhere on the board
/ELOAD/CurrentSink/MCU_DAC_ELOAD: TP17.1, U15.3 (+); also elsewhere on the board
GND: C60.2, U15.2 (-); also elsewhere on the board
unnamed: C61.1, R55.2, U15.4 (-)
unnamed: C61.2, R56.1, TP21.1, U15.1
unnamed: Q7.2 (G), R56.2, TP13.1
unnamed: Q7.3 (S), R55.1, R57.2, TP25.1

Parts of its further copies:
C63, C66, C69: 100n; C_0603_1608Metric
C64, C67, C70: 22p; C_0603_1608Metric
Q8, Q9, Q10: GT020N10Q; TO-247-3_Horizontal_TabUp
R59, R63, R67: 68k; R_0603_1608Metric
R60, R64, R68: 47R; R_0603_1608Metric
R61, R65, R69: FMF25FPJR010-LH; R_2512_6332Metric
TP14, TP15, TP16, TP18, TP19, TP20, TP22, TP23, TP24, TP26, TP27, TP28: TestPoint; TestPoint_Pad_D1.0mm
U16, U17, U18: OPA188AIDBVR; SOT-23-5

Connections of its further copies:
+12VA: C63.1, C66.1, C69.1, U16.5 (+), U17.5 (+), U18.5 (+); also elsewhere on the board
-BATT: R61.1, R65.1, R69.1; also elsewhere on the board
/BatteryV2/ELOAD: Q8.1 (D), Q9.1 (D), Q10.1 (D); also elsewhere on the board
/ELOAD/CurrentSink/MCU_DAC_ELOAD: TP18.1, TP19.1, TP20.1, U16.3 (+), U17.3 (+), U18.3 (+); also elsewhere on the board
GND: C63.2, C66.2, C69.2, U16.2 (-), U17.2 (-), U18.2 (-); also elsewhere on the board
unnamed: C64.1, R59.2, U16.4 (-)
unnamed: C64.2, R60.1, TP22.1, U16.1
unnamed: C67.1, R63.2, U17.4 (-)
unnamed: C67.2, R64.1, TP23.1, U17.1
unnamed: C70.1, R67.2, U18.4 (-)
unnamed: C70.2, R68.1, TP24.1, U18.1
unnamed: Q8.2 (G), R60.2, TP14.1
unnamed: Q8.3 (S), R59.1, R61.2, TP26.1
unnamed: Q9.2 (G), R64.2, TP15.1
unnamed: Q9.3 (S), R63.1, R65.2, TP27.1
unnamed: Q10.2 (G), R68.2, TP16.1
unnamed: Q10.3 (S), R67.1, R69.2, TP28.1

Notes on the sheet:
10 mOhm SHUNT 2W VOFFSET @ 6.25A: 62.5mV POWER @ 6.25A: 0.391W

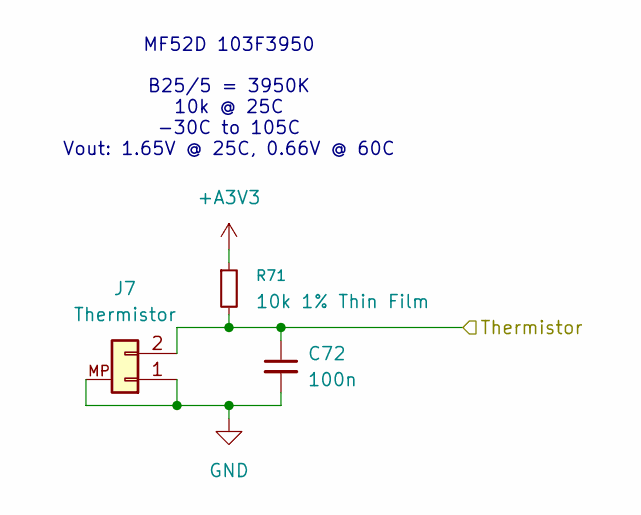
[picture p41: schematic ExtThermistor.kicad_sch]

Parts:
C72: 100n; C_0603_1608Metric
J7: Thermistor; JST_SH_SM02B-SRSS-TB_1x02-1MP_P1.00mm_Horizontal
R71: 10k 1% Thin Film; R_0603_1608Metric

Connections:
+A3V3: R71.1; also elsewhere on the board
/Temperature/ExtThermistor/Thermistor: C72.1, J7.2, R71.2; also elsewhere on the board
GND: C72.2, J7.1, J7.MP; also elsewhere on the board

Parts of its further copies:
C73, C74, C75, C76, C77, C78, C79, C82, C83, C84, C85: 100n; C_0603_1608Metric
J8, J9, J10, J11, J12, J13, J14, J15, J16, J17, J18: Thermistor; JST_SH_SM02B-SRSS-TB_1x02-1MP_P1.00mm_Horizontal
R72, R73, R74, R75, R76, R77, R78, R79, R80, R81, R82: 10k 1% Thin Film; R_0603_1608Metric

Connections of its further copies:
+A3V3: R72.1, R73.1, R74.1, R75.1, R76.1, R77.1, R78.1, R79.1, R80.1, R81.1, R82.1; also elsewhere on the board
/Temperature/ExtThermistor1/Thermistor: C73.1, J8.2, R72.2; also elsewhere on the board
/Temperature/ExtThermistor2/Thermistor: C74.1, J9.2, R73.2; also elsewhere on the board
/Temperature/ExtThermistor3/Thermistor: C75.1, J10.2, R74.2; also elsewhere on the board
/Temperature/ExtThermistor4/Thermistor: C76.1, J11.2, R75.2; also elsewhere on the board
/Temperature/ExtThermistor5/Thermistor: C77.1, J12.2, R76.2; also elsewhere on the board
/Temperature/ExtThermistor6/Thermistor: C78.1, J13.2, R77.2; also elsewhere on the board
/Temperature/ExtThermistor7/Thermistor: C79.1, J14.2, R78.2; also elsewhere on the board
/Temperature/ExtThermistor8/Thermistor: C82.1, J15.2, R79.2; also elsewhere on the board
/Temperature/ExtThermistor9/Thermistor: C83.1, J16.2, R80.2; also elsewhere on the board
/Temperature/ExtThermistor10/Thermistor: C84.1, J17.2, R81.2; also elsewhere on the board
/Temperature/ExtThermistor11/Thermistor: C85.1, J18.2, R82.2; also elsewhere on the board
GND: C73.2, C74.2, C75.2, C76.2, C77.2, C78.2, C79.2, C82.2, C83.2, C84.2, C85.2, J8.1, J8.MP, J9.1, J9.MP, J10.1, J10.MP, J11.1, J11.MP, J12.1, J12.MP, J13.1, J13.MP, J14.1, J14.MP, J15.1, J15.MP, J16.1, J16.MP, J17.1, J17.MP, J18.1, J18.MP; also elsewhere on the board

Notes on the sheet:
B25/5 = 3950K 10k @ 25C -30C to 105C Vout: 1.65V @ 25C, 0.66V @ 60C
MF52D 103F3950

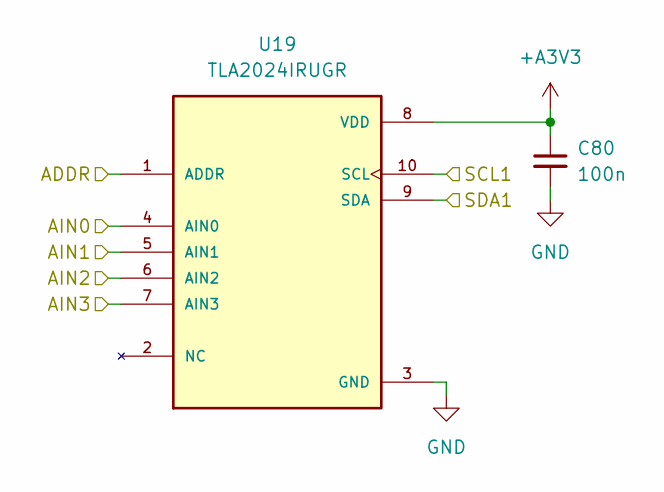
[picture p42: schematic ExtThermistorADC.kicad_sch]

Parts:
C80: 100n; C_0603_1608Metric
U19: TLA2024IRUGR; IC_TLA2024IRUGR; PARTREV November 2017

Connections:
+A3V3: C80.1, U19.1 (ADDR), U19.8 (VDD); also elsewhere on the board
/MCU/SCL1: U19.10 (SCL); also elsewhere on the board
/MCU/SDA1: U19.9 (SDA); also elsewhere on the board
/Temperature/ExtThermistor1/Thermistor: U19.5 (AIN1); also elsewhere on the board
/Temperature/ExtThermistor2/Thermistor: U19.6 (AIN2); also elsewhere on the board
/Temperature/ExtThermistor7/Thermistor: U19.7 (AIN3); also elsewhere on the board
/Temperature/ExtThermistor/Thermistor: U19.4 (AIN0); also elsewhere on the board
GND: C80.2, U19.3 (GND); also elsewhere on the board

Parts of its further copies:
C81, C86: 100n; C_0603_1608Metric
U20, U21: TLA2024IRUGR; IC_TLA2024IRUGR; PARTREV November 2017

Connections of its further copies:
+A3V3: C81.1, C86.1, U20.8 (VDD), U21.8 (VDD); also elsewhere on the board
/MCU/SCL1: U20.10 (SCL), U21.1 (ADDR), U21.10 (SCL); also elsewhere on the board
/MCU/SDA1: U20.9 (SDA), U21.9 (SDA); also elsewhere on the board
/Temperature/ExtThermistor3/Thermistor: U20.4 (AIN0); also elsewhere on the board
/Temperature/ExtThermistor4/Thermistor: U20.6 (AIN2); also elsewhere on the board
/Temperature/ExtThermistor5/Thermistor: U20.7 (AIN3); also elsewhere on the board
/Temperature/ExtThermistor6/Thermistor: U20.5 (AIN1); also elsewhere on the board
/Temperature/ExtThermistor8/Thermistor: U21.4 (AIN0); also elsewhere on the board
/Temperature/ExtThermistor9/Thermistor: U21.6 (AIN2); also elsewhere on the board
/Temperature/ExtThermistor10/Thermistor: U21.7 (AIN3); also elsewhere on the board
/Temperature/ExtThermistor11/Thermistor: U21.5 (AIN1); also elsewhere on the board
GND: C81.2, C86.2, U20.1 (ADDR), U20.3 (GND), U21.3 (GND); also elsewhere on the board

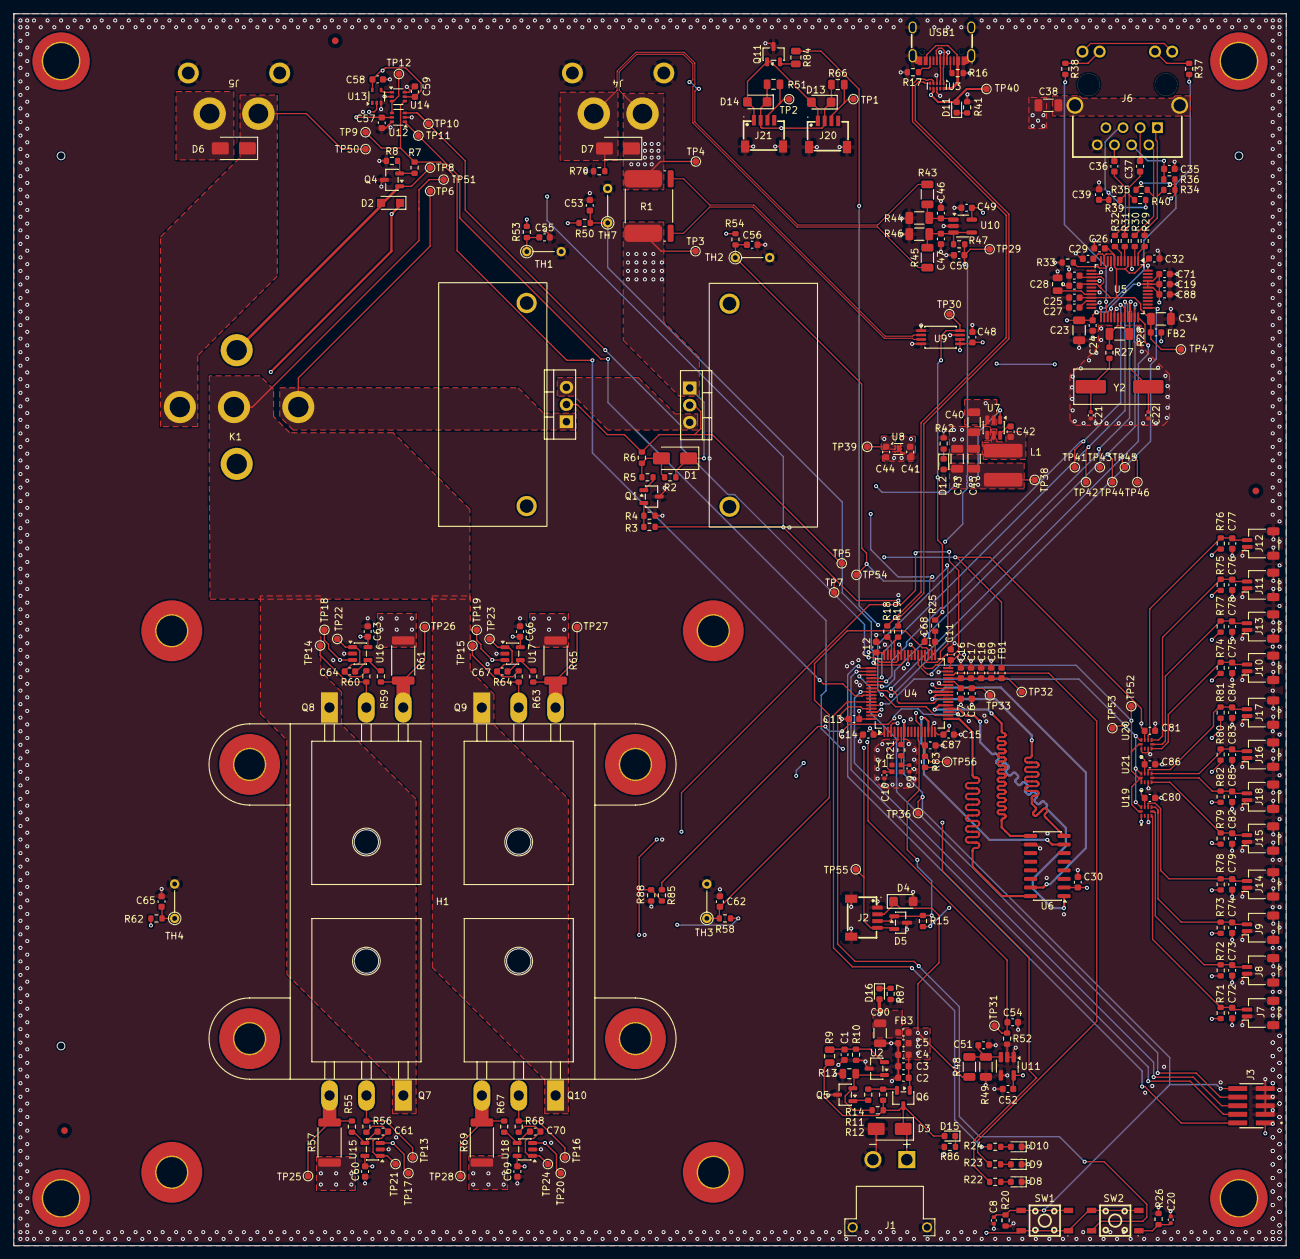
[picture p43: board BatteryTesterV2.1.kicad_pcb from above]

Board: 4 copper layers, 188.0 x 182.0 mm, 312 parts (0 on the bottom side), 153 nets.

Other parts of the board:
H1: Spread_MountingHole; Spreader_Mount
